teno1608/Do-An-Tot-Nghiep-2014/co cau leo thang.JPG

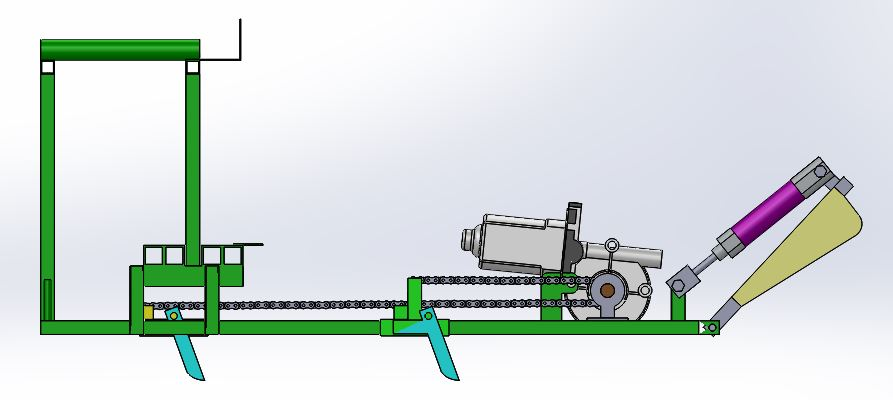
co cau leo thang.JPG
