teno1608/Do-An-Tot-Nghiep-2014/mater.JPG

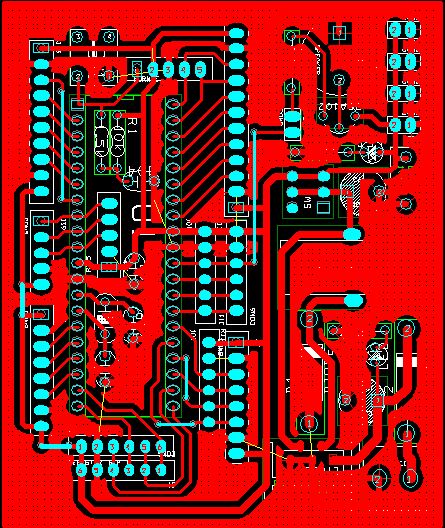
mater.JPG
