teno1608/Do-An-Tot-Nghiep-2014/anh tong the.JPG

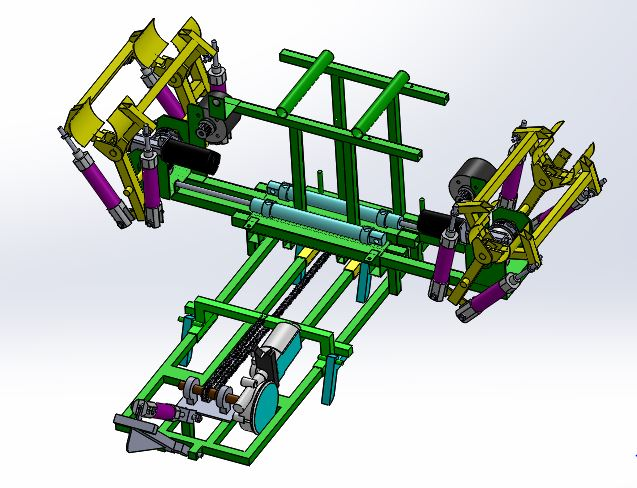
anh tong the.JPG
