teno1608/Do-An-Tot-Nghiep-2014/canh tay kep.JPG

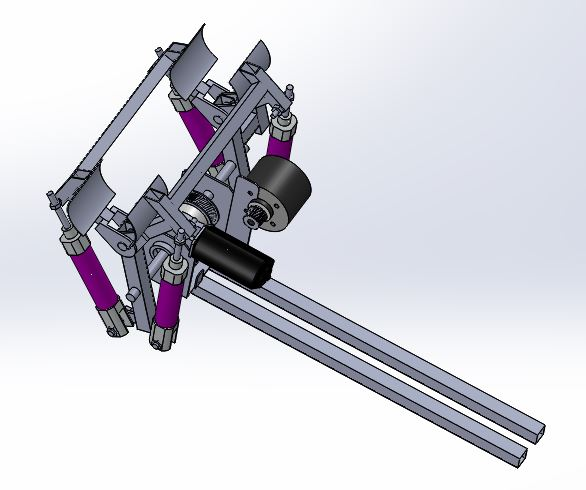
canh tay kep.JPG
