teno1608/Do-An-Tot-Nghiep-2014/Capture.JPG

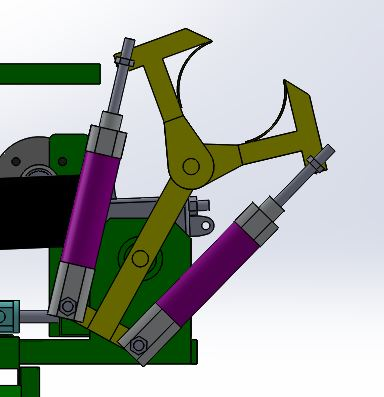
Capture.JPG
