teno1608/Do-An-Tot-Nghiep-2014/co cau giao tiep.JPG

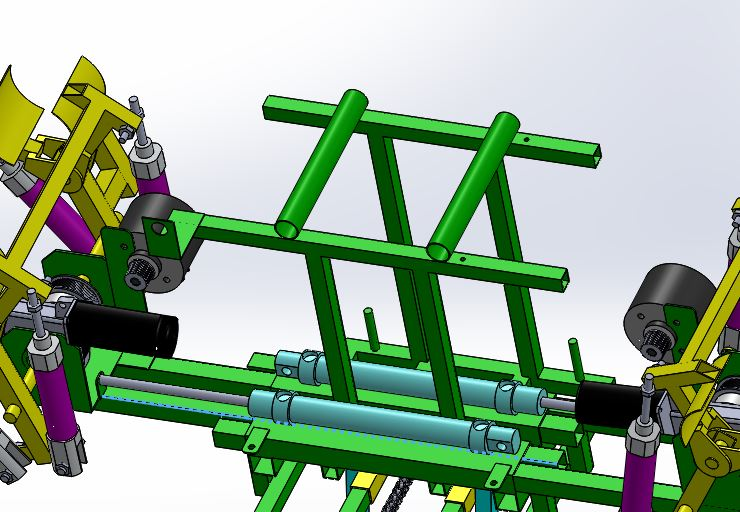
co cau giao tiep.JPG
