teno1608/Do-An-Tot-Nghiep-2014/co cau qua cot.JPG

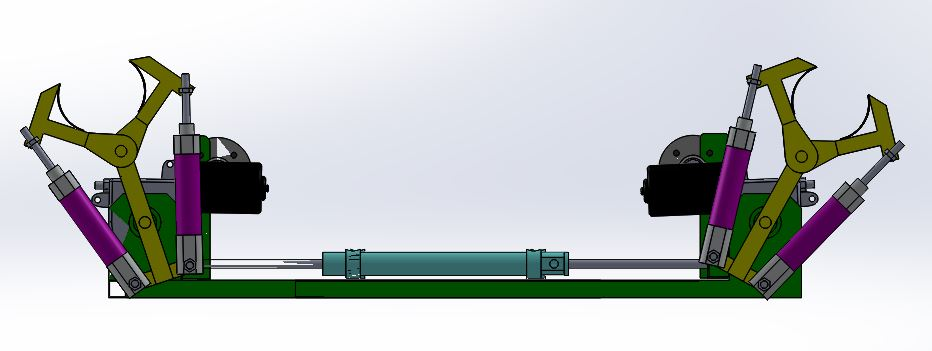
co cau qua cot.JPG
