teno1608/Do-An-Tot-Nghiep-2014/dluc.JPG

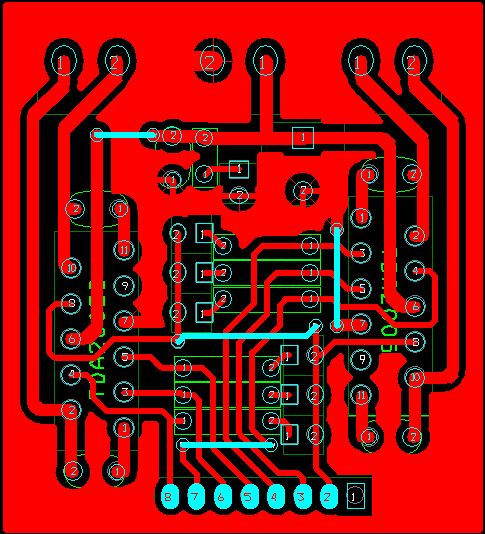
dluc.JPG
