teno1608/Do-An-Tot-Nghiep-2014/IMG_20140521_151754.jpg

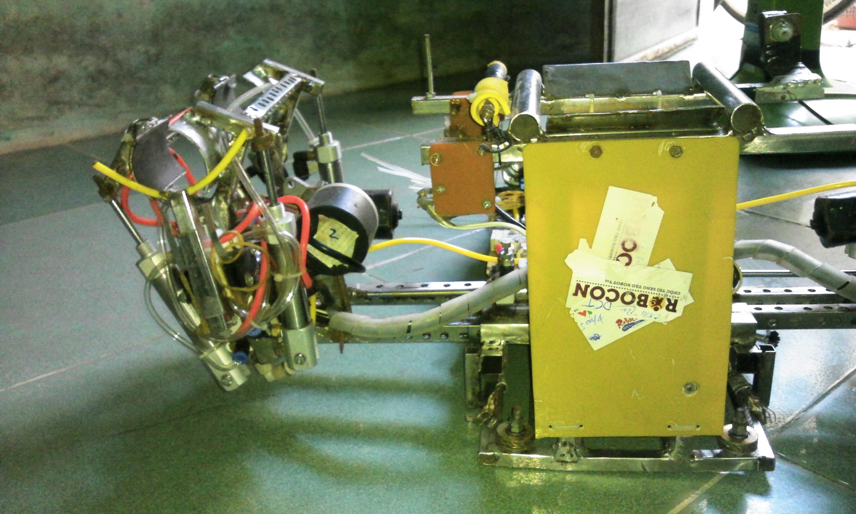
IMG_20140521_151754.jpg
