teno1608/Do-An-Tot-Nghiep-2014/kich van.JPG

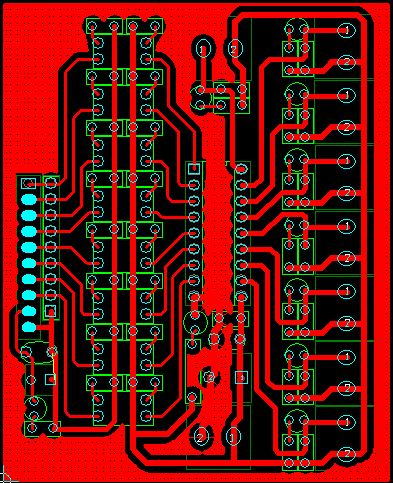
kich van.JPG
