teno1608/Do-An-Tot-Nghiep-2014/leo thang co cau.JPG

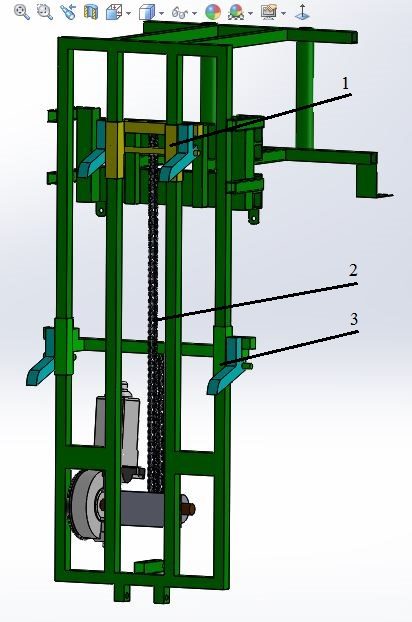
leo thang co cau.JPG
