teno1608/Do-An-Tot-Nghiep-2014/leo thang.JPG

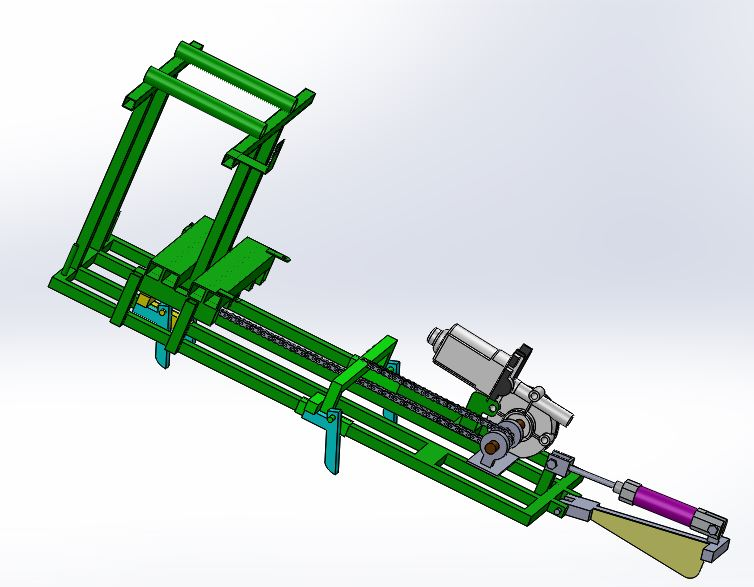
leo thang.JPG
