teno1608/Do-An-Tot-Nghiep-2014/luu do1.JPG

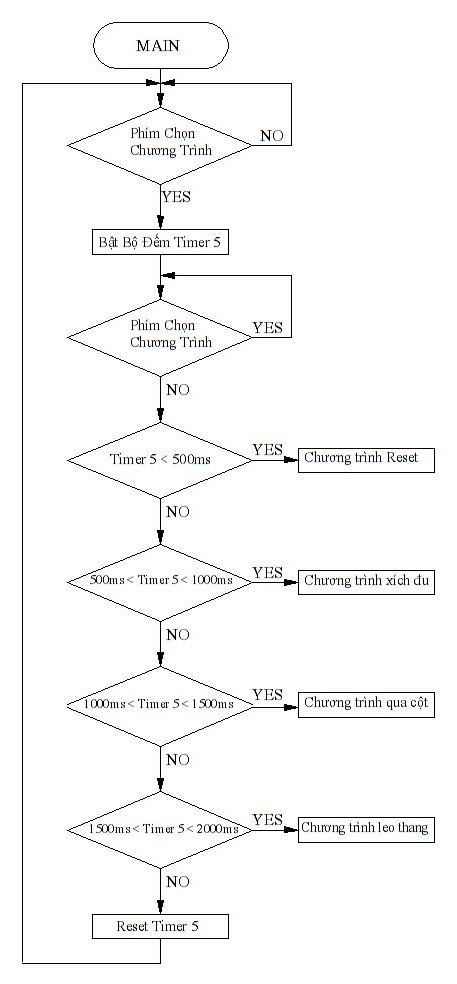
luu do1.JPG
