teno1608/Do-An-Tot-Nghiep-2014/luu do 2.JPG

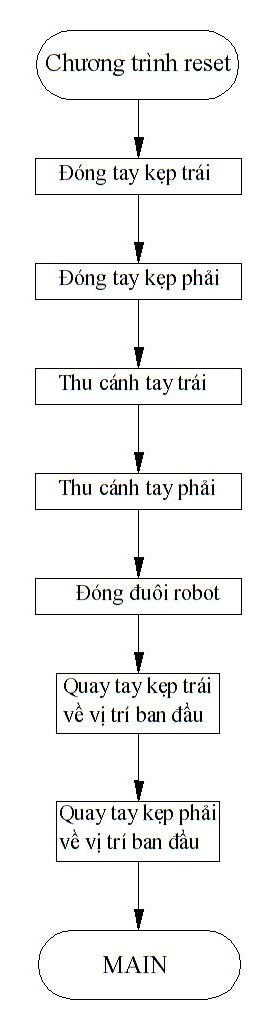
luu do 2.JPG
