teno1608/Do-An-Tot-Nghiep-2014/luu do 3.JPG

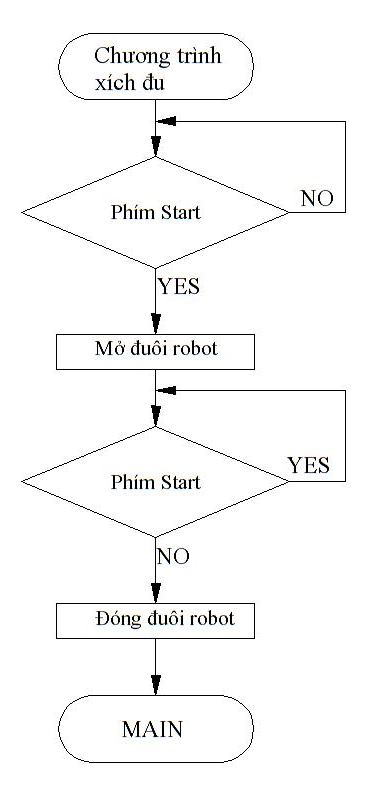
luu do 3.JPG
