teno1608/Do-An-Tot-Nghiep-2014/luu do 4.JPG

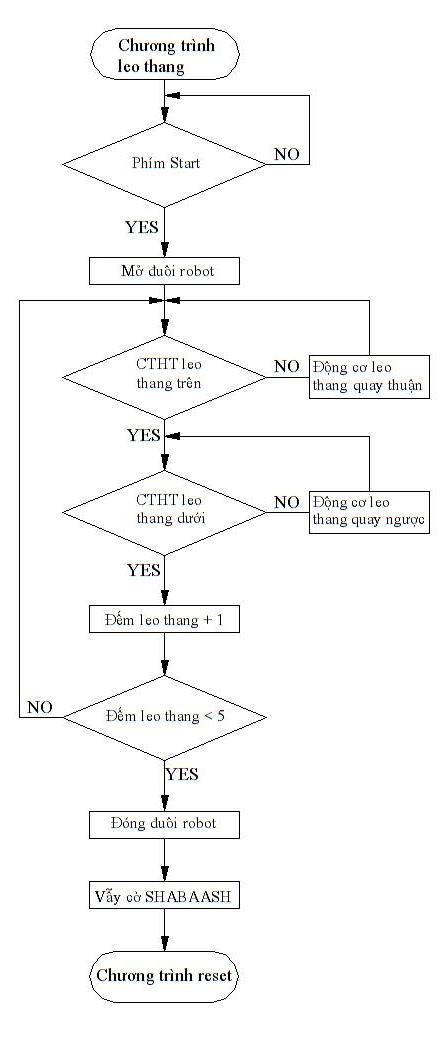
luu do 4.JPG
