teno1608/Do-An-Tot-Nghiep-2014/luu do 5.JPG

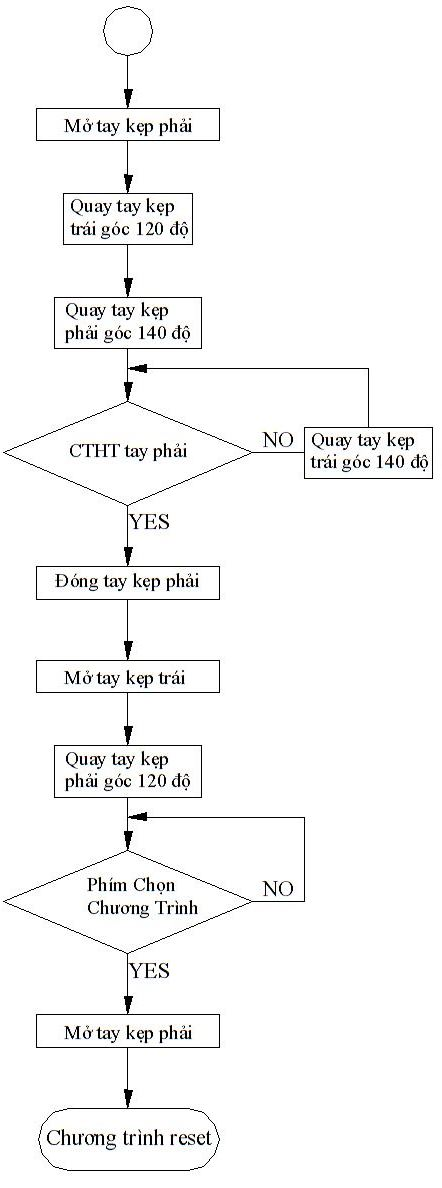
luu do 5.JPG
