teno1608/Do-An-Tot-Nghiep-2014/luu do 6.JPG

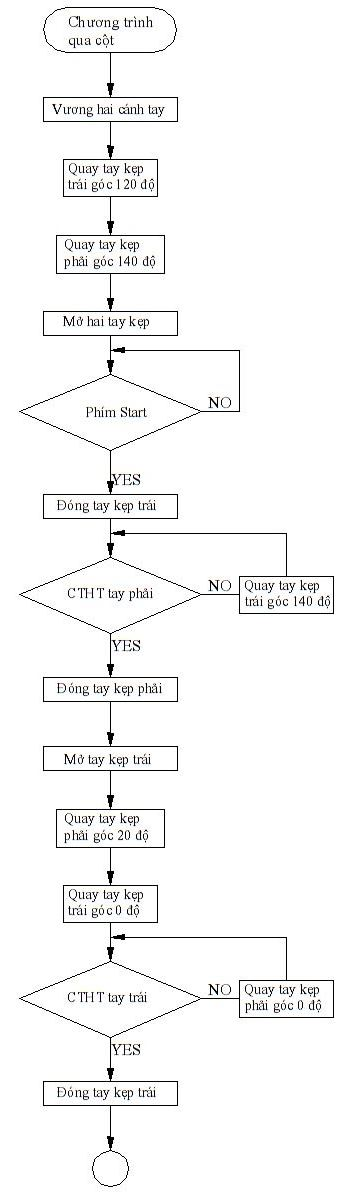
luu do 6.JPG
