teno1608/Do-An-Tot-Nghiep-2014/mach pid.JPG

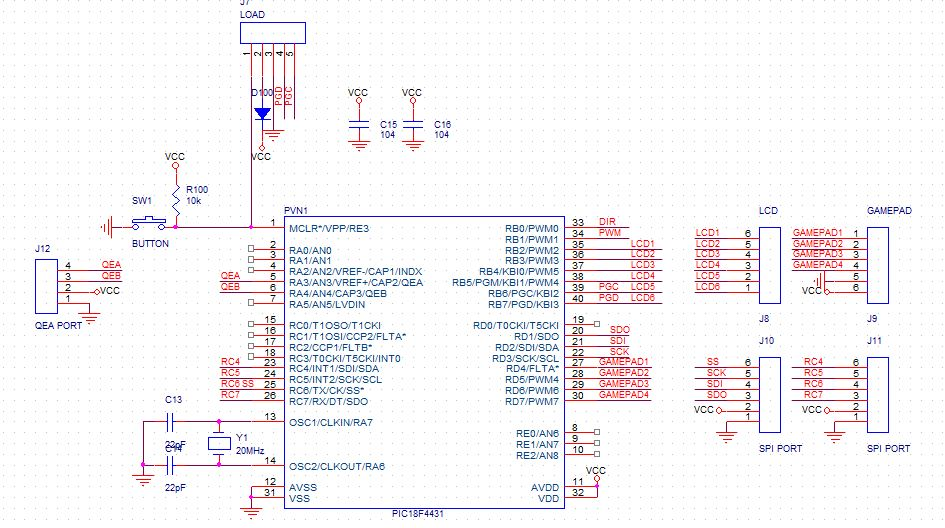
mach pid.JPG
