teno1608/Do-An-Tot-Nghiep-2014/mach trung tam.JPG

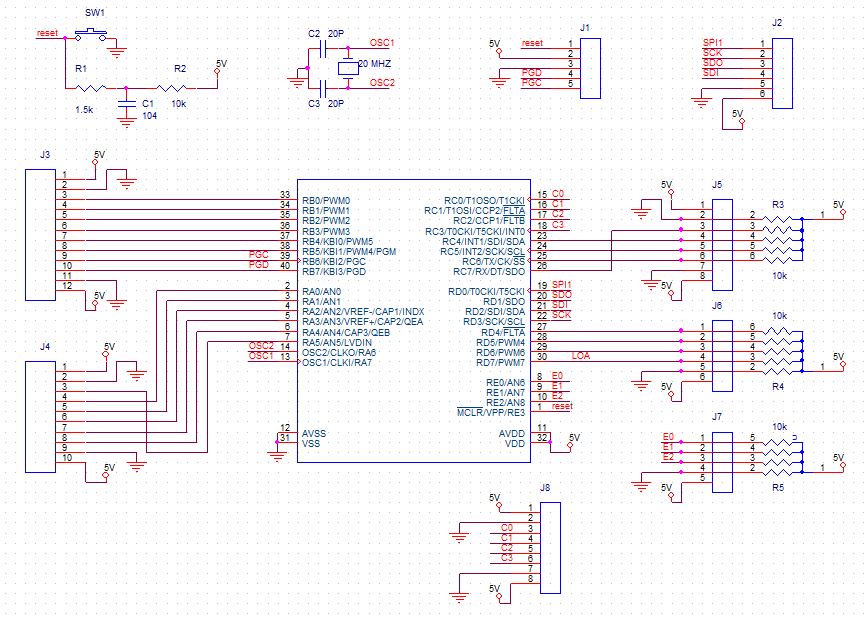
mach trung tam.JPG
