teno1608/Do-An-Tot-Nghiep-2014/pic18f.JPG

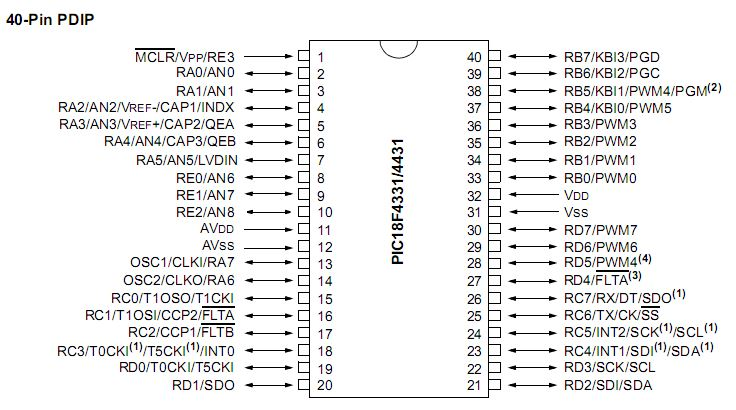
pic18f.JPG
