teno1608/Do-An-Tot-Nghiep-2014/quay dong co lep.JPG

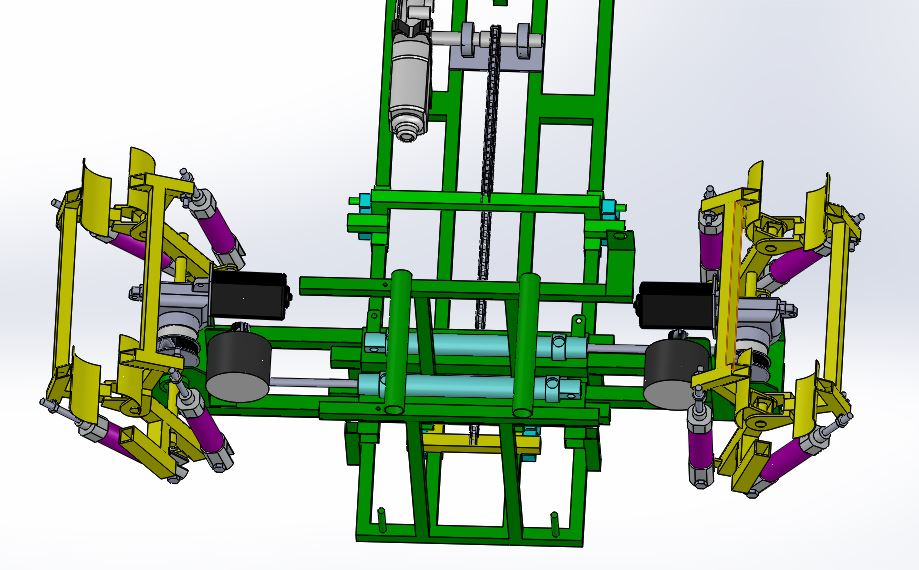
quay dong co lep.JPG
