teno1608/Do-An-Tot-Nghiep-2014/so do tinh kep.jpg

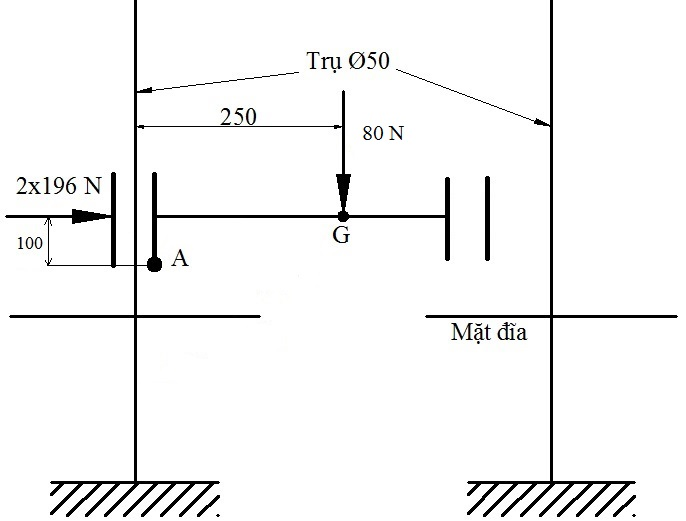
so do tinh kep.jpg
