teno1608/Do-An-Tot-Nghiep-2014/tinhlucleocauthang.JPG

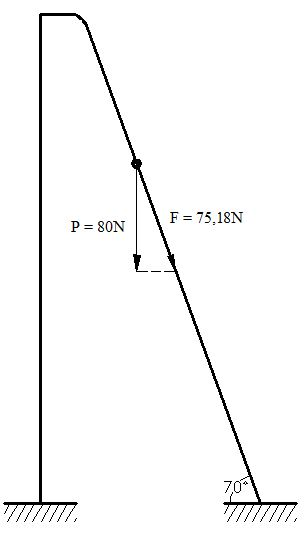
tinhlucleocauthang.JPG
