teno1608/Do-An-Tot-Nghiep-2014/auto/thư viện/onmi2/omni.SLDASM

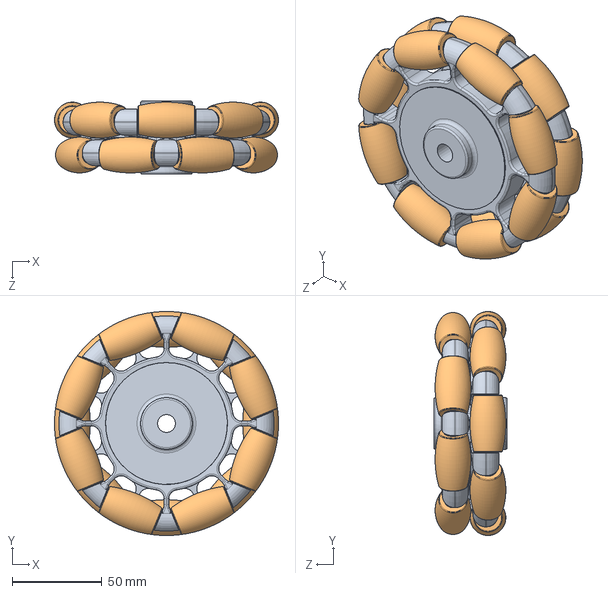
[picture p42: CAD file, 2022-07-13]
auto/thư viện/onmi2/omni.SLDASM
125.0 x 125.0 x 41.0 mm
don x 2
conlan x 16
