teno1608/Do-An-Tot-Nghiep-2014/auto/thư viện/onmi2/banh hoan chinh.SLDASM

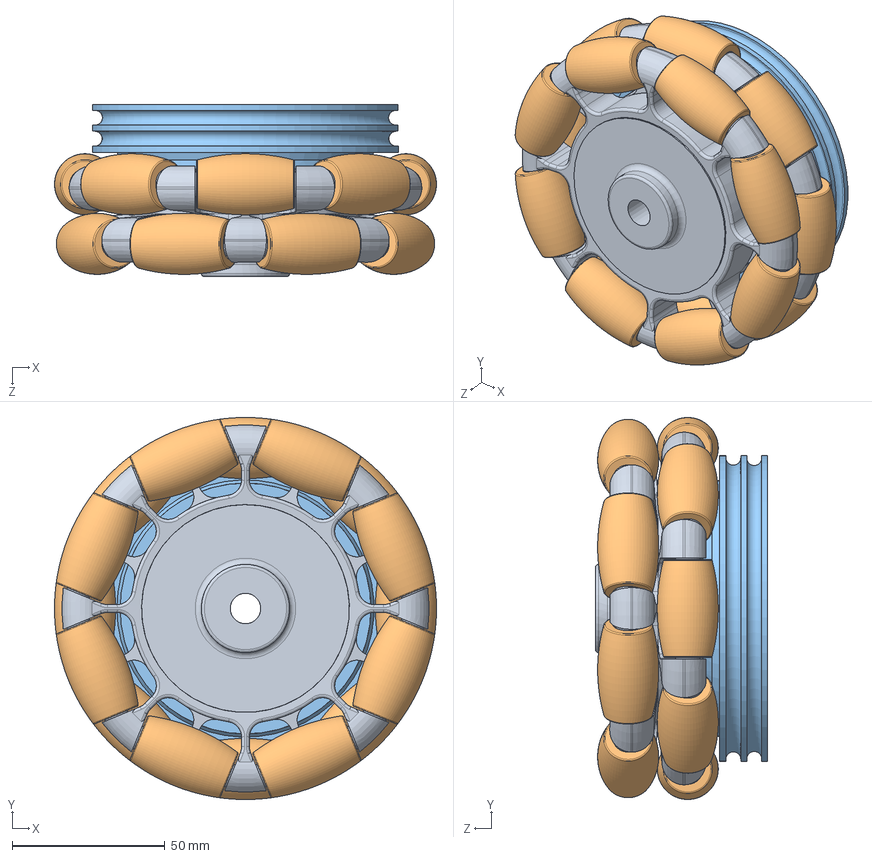
[picture p43: CAD file, 2022-07-13]
auto/thư viện/onmi2/banh hoan chinh.SLDASM
125.0 x 125.0 x 56.4 mm
don x 2
conlan x 16
buli_tua100
