teno1608/Do-An-Tot-Nghiep-2014/auto/encoder/laprap.SLDASM

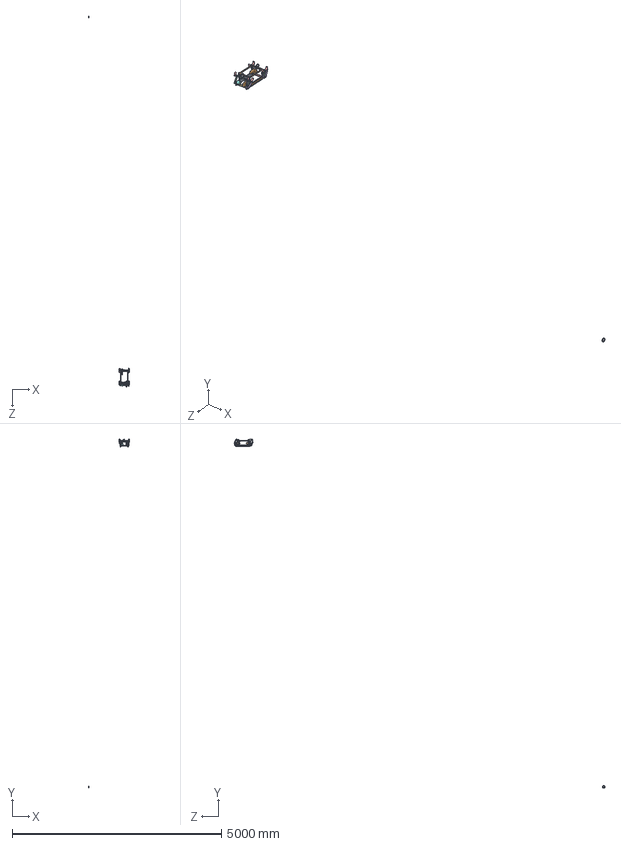
[picture p44: CAD file, 2022-07-13]
auto/encoder/laprap.SLDASM
980.0 x 8334.7 x 8854.6 mm
ray1 x 2
ray2 x 2
obi x 4
taykep x 2
hop20dai180
vuong20x20x20 x 2
hop20x10x160
ENCODER 100Xung
hop10x10x100 x 4
khung280x180
banle_1 x 8
banle_2 x 8
makep x 8
xilanh 30 x 4
daunoipitong x 4
trục 30 x 4
hotro x 3
dong co leb-phai x 2
