teno1608/Do-An-Tot-Nghiep-2014/auto/doan xich2.SLDASM

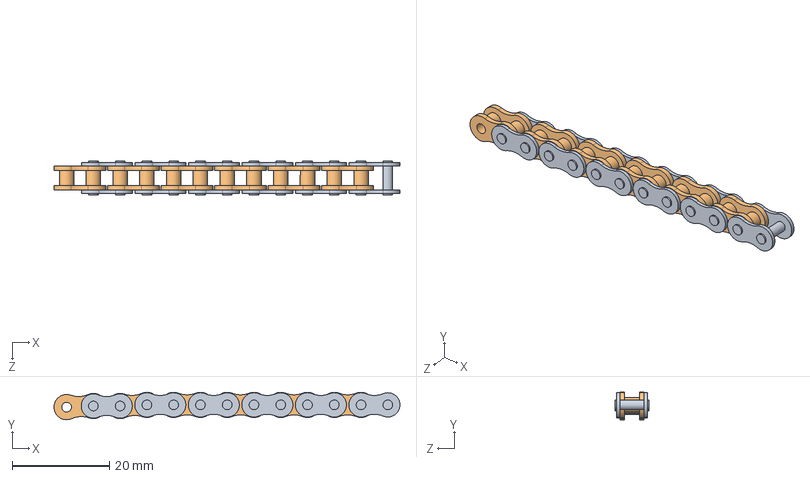
[picture p45: CAD file, 2022-07-13]
auto/doan xich2.SLDASM
71.1 x 5.66 x 7.00 mm
mac xich lon x 6
mac xich nho x 6
