teno1608/Do-An-Tot-Nghiep-2014/auto/thư viện/xilanh 200 mate.SLDPRT.SLDASM

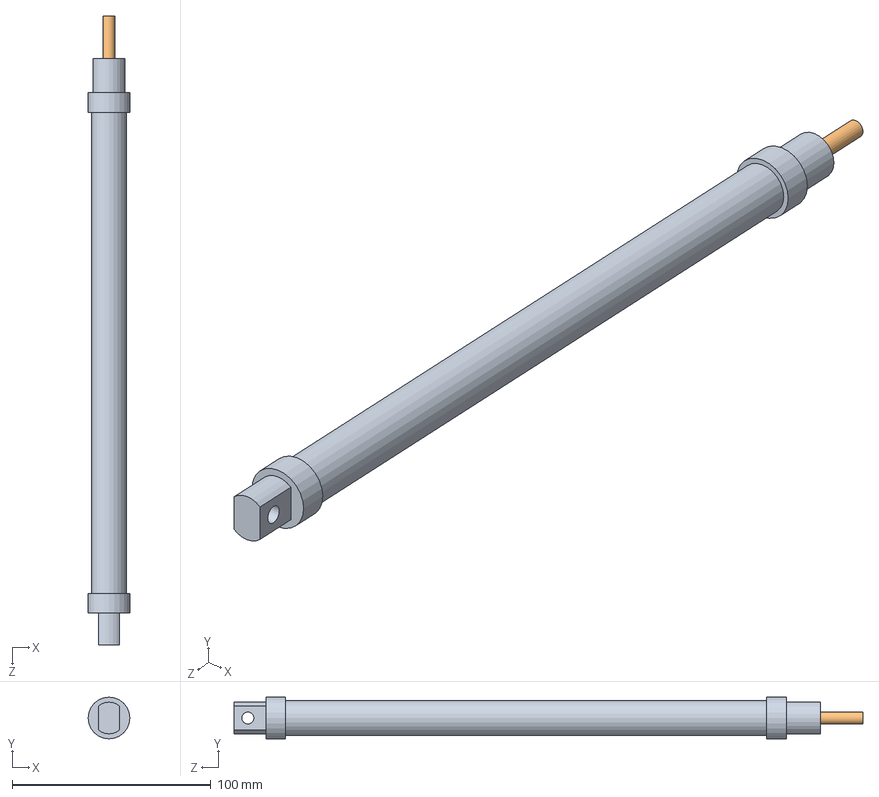
[picture p46: CAD file, 2022-07-13]
auto/thư viện/xilanh 200 mate.SLDPRT.SLDASM
21.0 x 21.0 x 316.5 mm
xilanh 200
trục xilanh 200
