teno1608/Do-An-Tot-Nghiep-2014/auto/lap rap canh tay phai.SLDASM

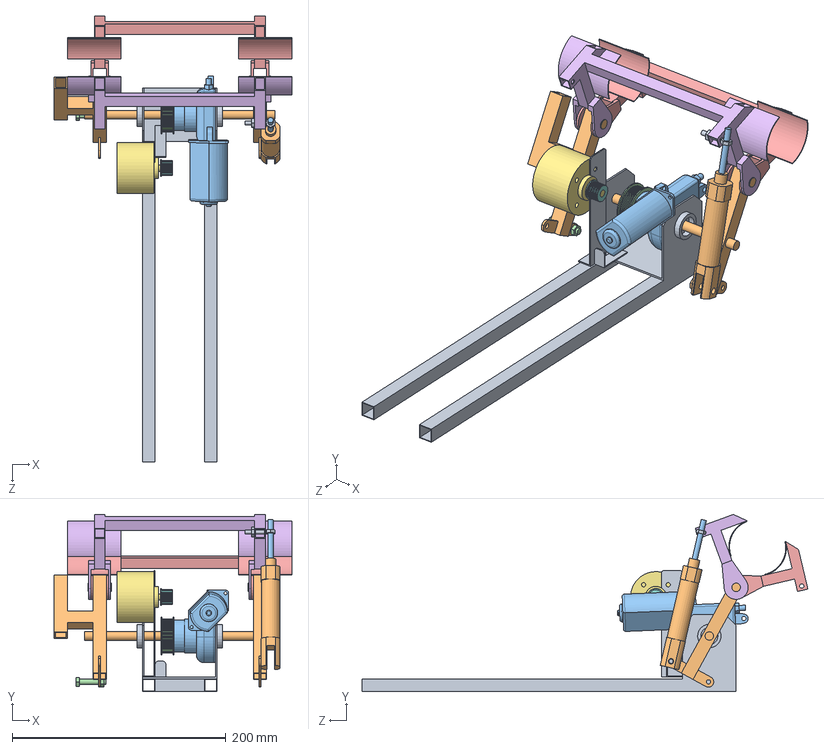
[picture p47: CAD file, 2022-07-13]
auto/lap rap canh tay phai.SLDASM
222.8 x 165.8 x 417.3 mm
than tay kep
ma kep phai
ma kep trai
