teno1608/Do-An-Tot-Nghiep-2014/auto/lap rap auto.SLDASM

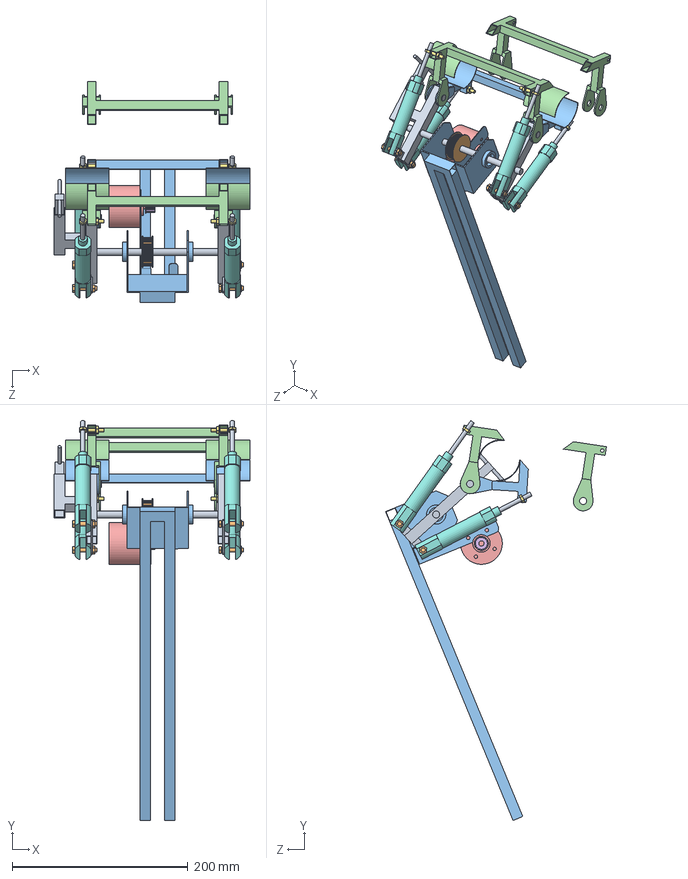
[picture p49: CAD file, 2022-07-13]
auto/lap rap auto.SLDASM
222.8 x 454.9 x 251.3 mm
than tay kep
banh rrang encoder
ma kep phai
ma kep trai
ENCODER 100Xung
banh rang encoder nho
oc pitong x 4
xilanh 30 x 4
trục xilanh 50 x 4
oc pitong duoi x 4
raytrai
