teno1608/Do-An-Tot-Nghiep-2014/auto/thư viện/xilanh 50 mate.SLDASM

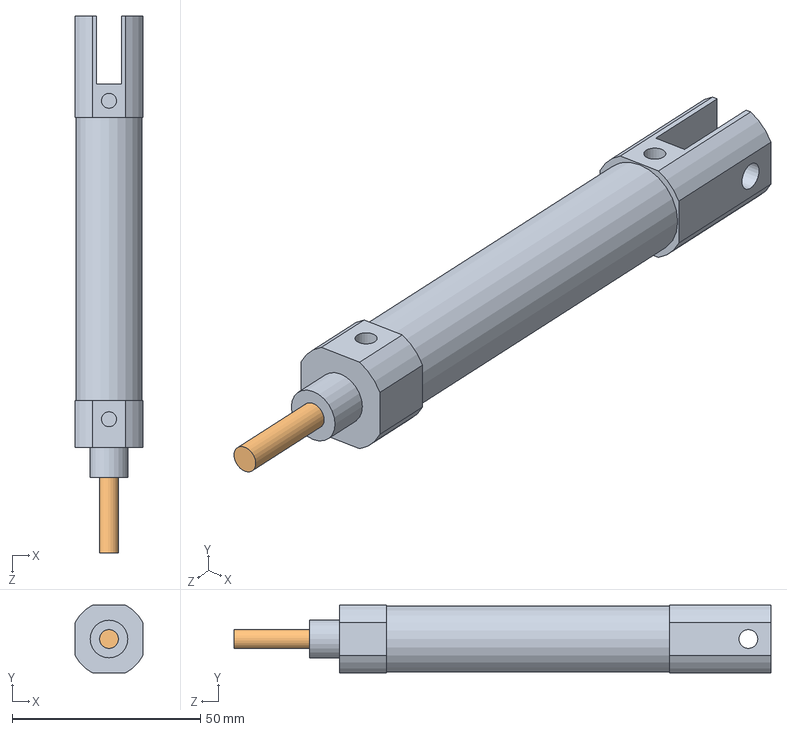
[picture p50: CAD file, 2022-07-13]
auto/thư viện/xilanh 50 mate.SLDASM
18.0 x 18.0 x 142.5 mm
xilanh 50
trục xilanh 50
