teno1608/Do-An-Tot-Nghiep-2014/auto/lap rap canh tay trai.SLDASM

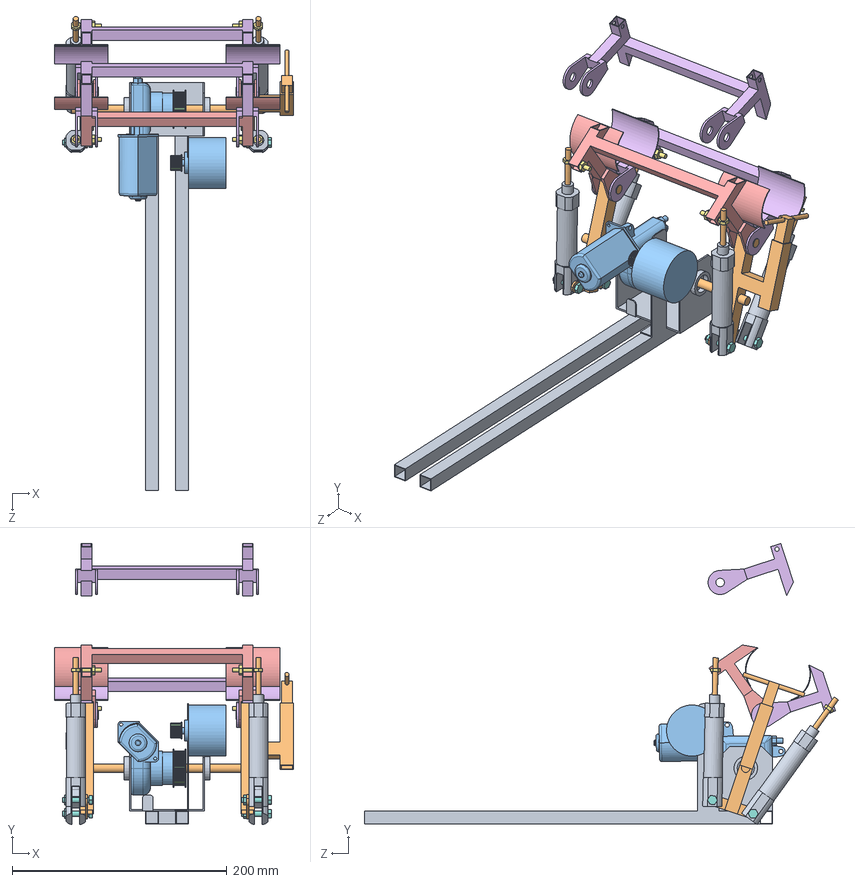
[picture p51: CAD file, 2022-07-13]
auto/lap rap canh tay trai.SLDASM
222.8 x 261.7 x 441.3 mm
raytrai
than tay kep
dong co led trai tay
banh rrang encoder
ma kep phai
ma kep trai
oc pitong x 4
oc pitong duoi x 4
xilanh 30 x 4
trục xilanh 50 x 4
ENCODER 100Xung
banh rang encoder nho
