teno1608/Do-An-Tot-Nghiep-2014/auto/nhong xich.SLDASM

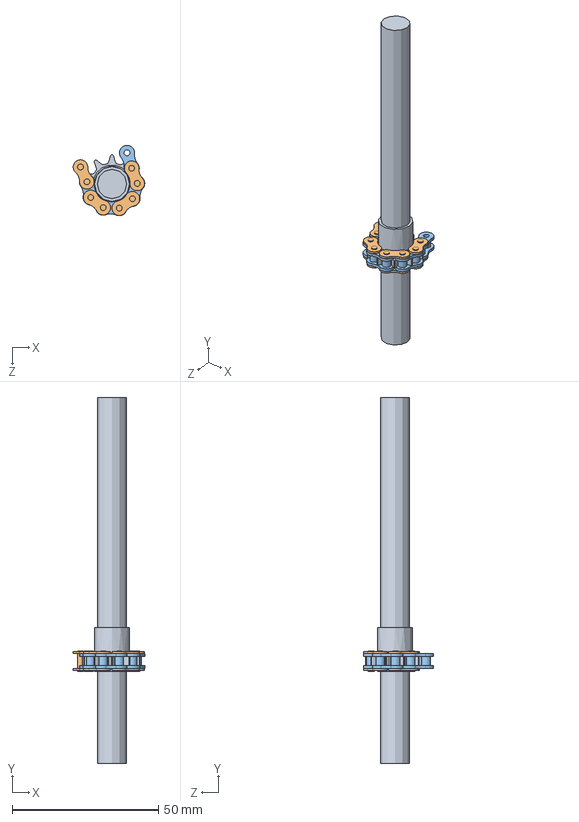
[picture p52: CAD file, 2022-07-13]
auto/nhong xich.SLDASM
24.5 x 125.0 x 24.1 mm
nhoong
mac xich lon x 4
mac xich nho x 4
