teno1608/Do-An-Tot-Nghiep-2014/auto/thư viện/xilanh 75 mate.SLDASM

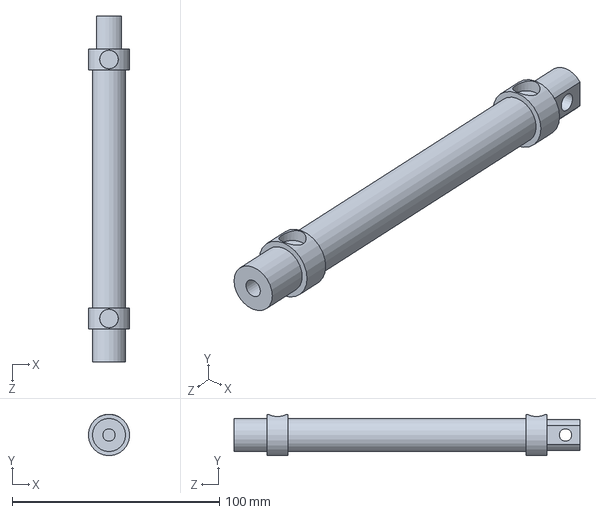
[picture p53: CAD file, 2022-07-13]
auto/thư viện/xilanh 75 mate.SLDASM
20.0 x 20.0 x 167.0 mm
