teno1608/Do-An-Tot-Nghiep-2014/auto/lap rap hoan chinh auto robot.SLDASM

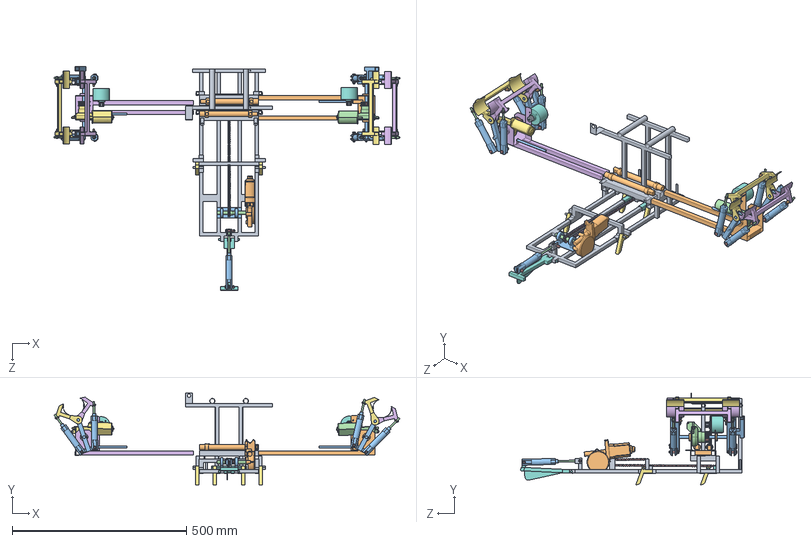
[picture p54: CAD file, 2022-07-13]
auto/lap rap hoan chinh auto robot.SLDASM
993.7 x 263.5 x 642.3 mm
de auto
rayphai
than tay kep x 2
dong co led phai tay
banh rrang encoder x 2
ma kep phai x 2
ma kep trai x 2
ENCODER 100Xung x 2
banh rang encoder nho x 2
oc pitong x 8
xilanh 30 x 9
trục xilanh 50 x 9
oc pitong duoi x 10
raytrai
dong co led trai tay
ray_truot_giua
ray_truot_ben
dong co leb
o do bi leo thang
nhoong
mac xich lon x 46
mac xich nho x 46
lay x 4
duoi
chu u
xilanh HT75 pi 16 x 2
trục xilanh 75 x 2
