teno1608/Do-An-Tot-Nghiep-2014/auto/thư viện/xilanh 100 mate.SLDASM

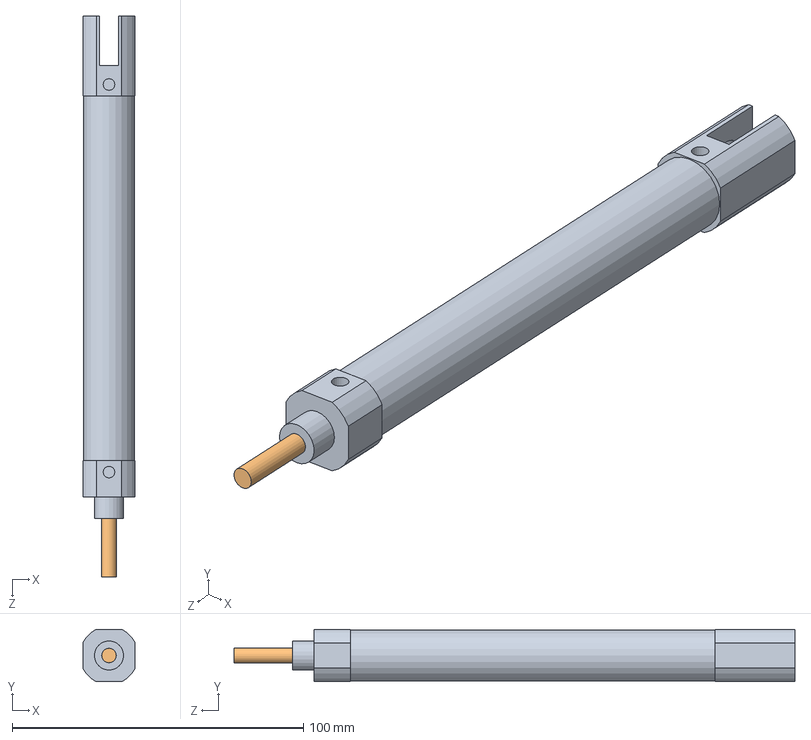
[picture p55: CAD file, 2022-07-13]
auto/thư viện/xilanh 100 mate.SLDASM
18.0 x 18.0 x 192.5 mm
xilanh 100
trục xilanh 100
