teno1608/Do-An-Tot-Nghiep-2014/auto/trượt lên thang trong.SLDASM

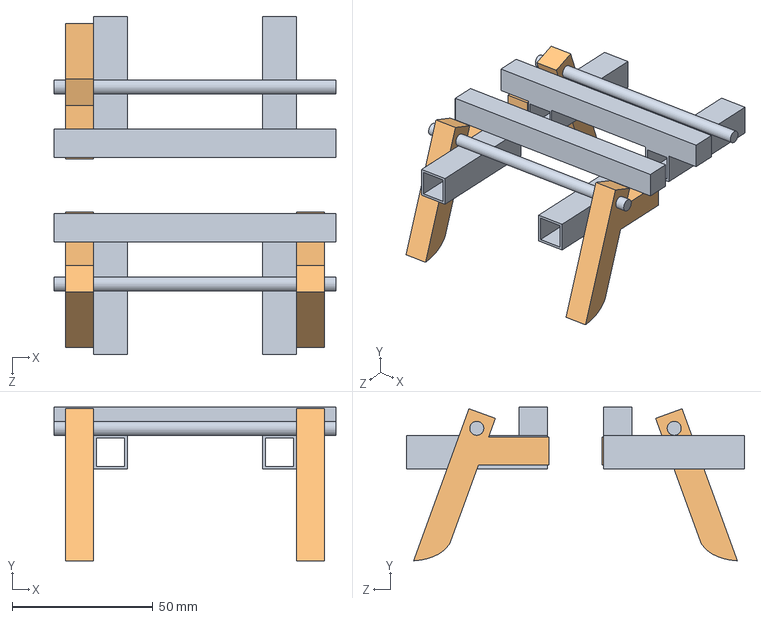
[picture p56: CAD file, 2022-07-13]
auto/trượt lên thang trong.SLDASM
100.0 x 54.5 x 120.0 mm
lay x 2
ray_truot_giua
