teno1608/Do-An-Tot-Nghiep-2014/auto/cơ cấu trượt lên thang ngoài.SLDASM

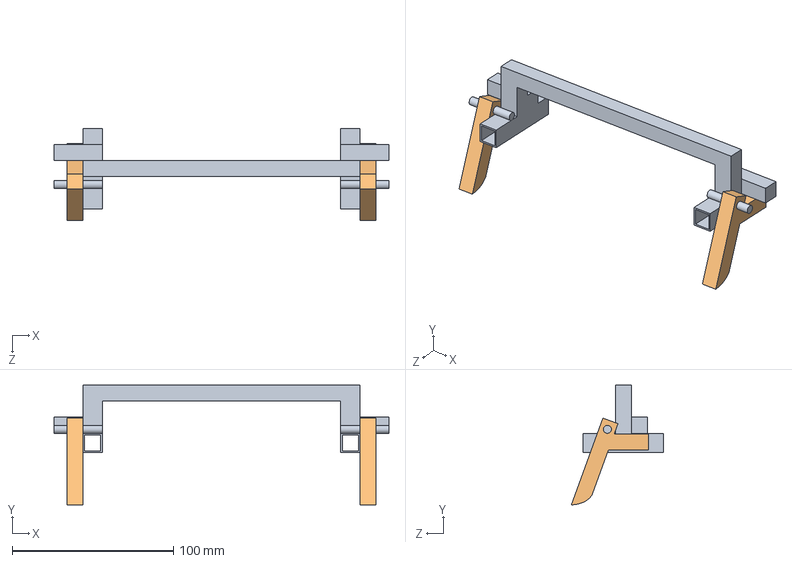
[picture p57: CAD file, 2022-07-13]
auto/cơ cấu trượt lên thang ngoài.SLDASM
208.0 x 74.5 x 57.4 mm
ray_truot_ben
lay x 2
