teno1608/Do-An-Tot-Nghiep-2014/auto/thư viện/xilanh 30 mate.SLDASM

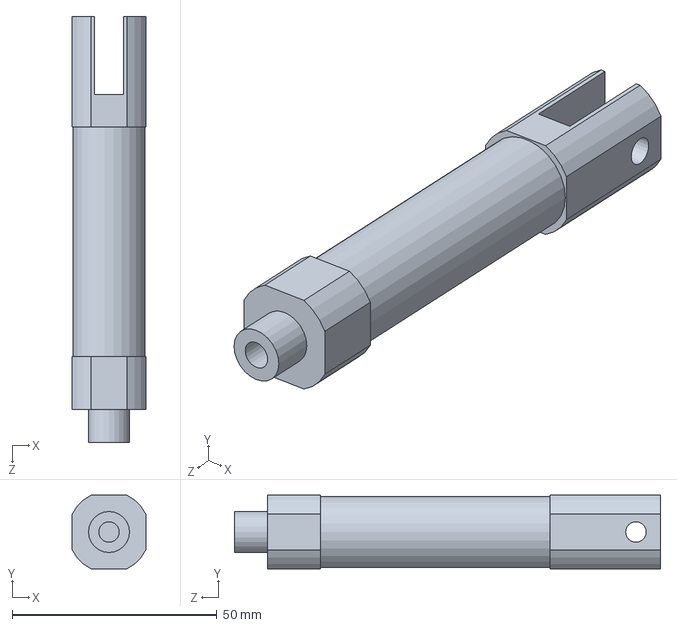
[picture p58: CAD file, 2022-07-13]
auto/thư viện/xilanh 30 mate.SLDASM
18.0 x 18.0 x 104.0 mm
