teno1608/Do-An-Tot-Nghiep-2014/auto/dong co led phai tay.SLDPRT

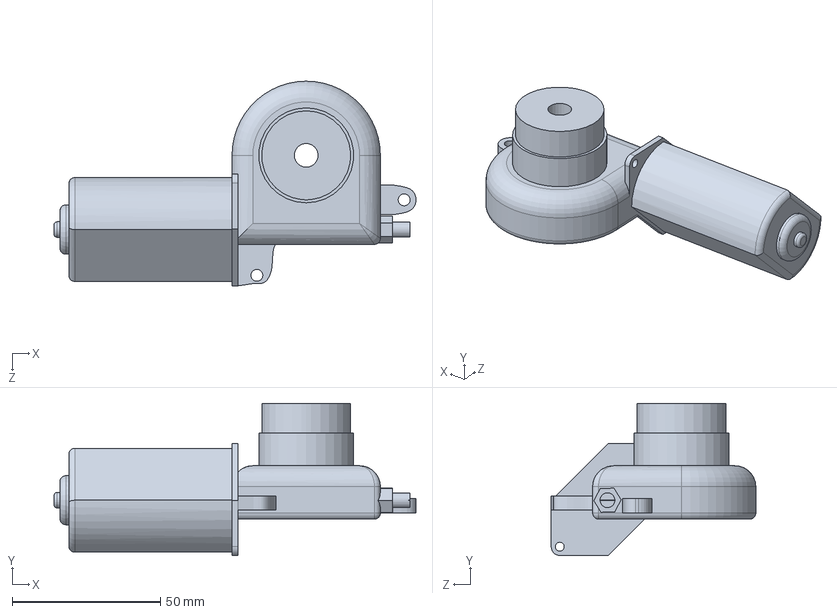
[picture p59: CAD file, 2022-07-13]
auto/dong co led phai tay.SLDPRT
122.0 x 51.3 x 69.0 mm
