teno1608/Do-An-Tot-Nghiep-2014/auto/thư viện/onmi2/conlan.SLDPRT

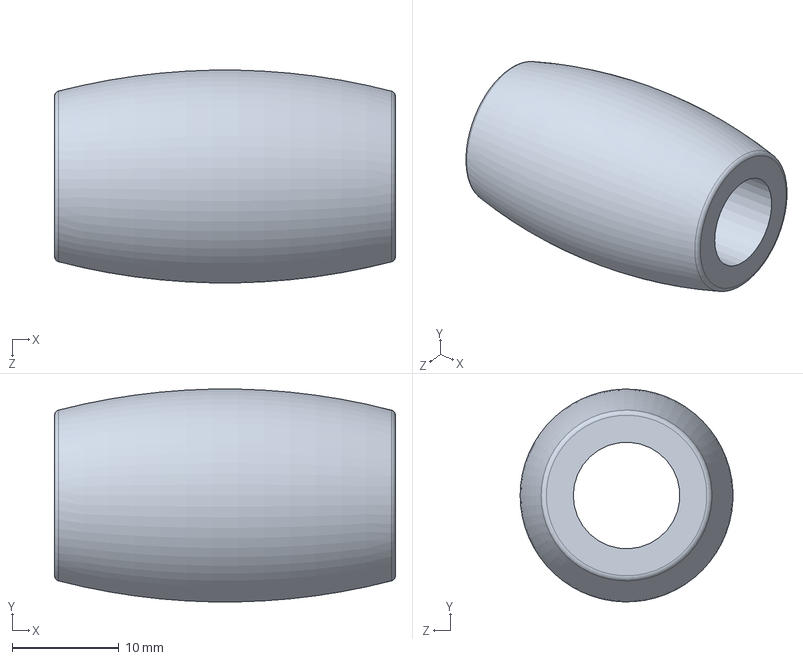
[picture p60: CAD file, 2022-07-13]
auto/thư viện/onmi2/conlan.SLDPRT
32.0 x 20.0 x 20.0 mm
