teno1608/Do-An-Tot-Nghiep-2014/auto/thư viện/trục xilanh 200.SLDPRT

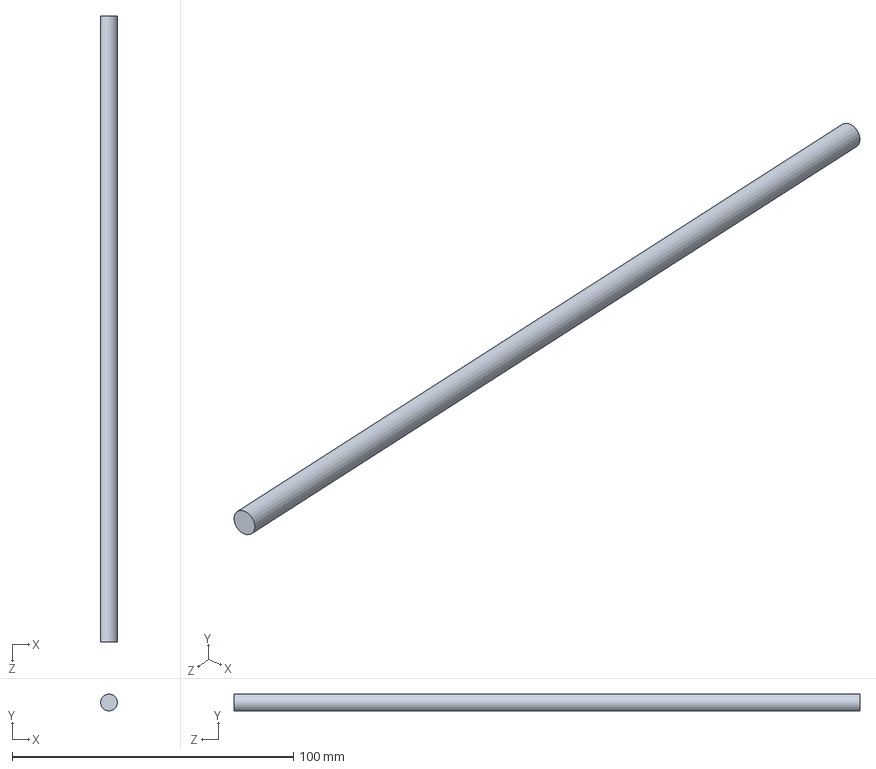
[picture p61: CAD file, 2022-07-13]
auto/thư viện/trục xilanh 200.SLDPRT
6.00 x 6.00 x 222.5 mm
