teno1608/Do-An-Tot-Nghiep-2014/auto/than tay kep.SLDPRT

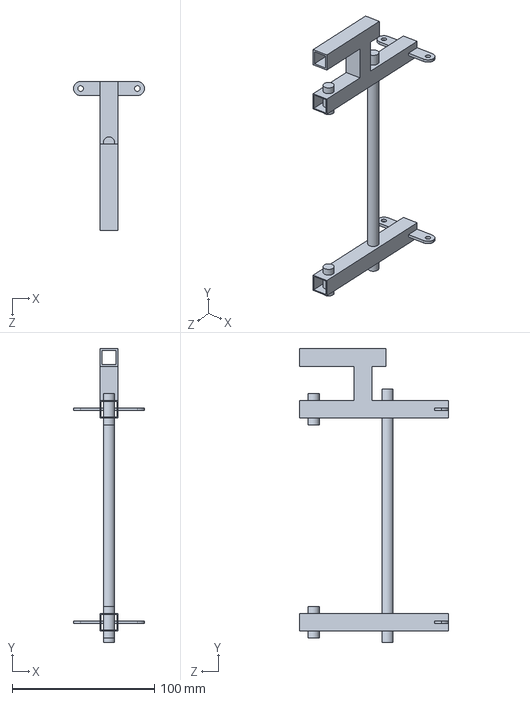
[picture p62: CAD file, 2022-07-13]
auto/than tay kep.SLDPRT
50.0 x 207.0 x 105.0 mm
