teno1608/Do-An-Tot-Nghiep-2014/auto/thư viện/trục 30.SLDPRT

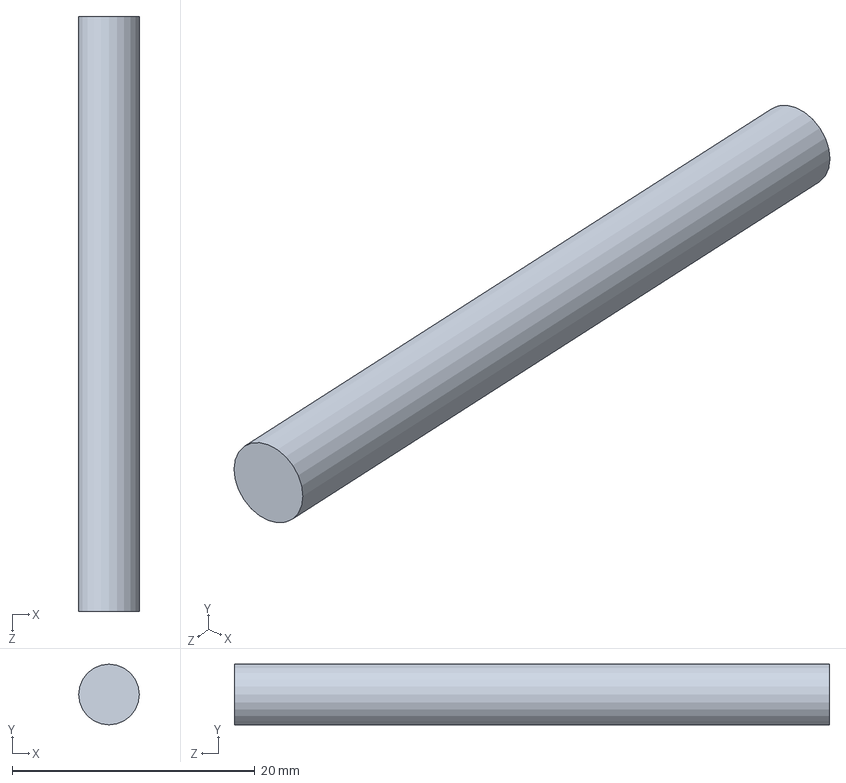
[picture p63: CAD file, 2022-07-13]
auto/thư viện/trục 30.SLDPRT
5.00 x 5.00 x 49.0 mm
