teno1608/Do-An-Tot-Nghiep-2014/auto/thư viện/buli_tua100.SLDPRT

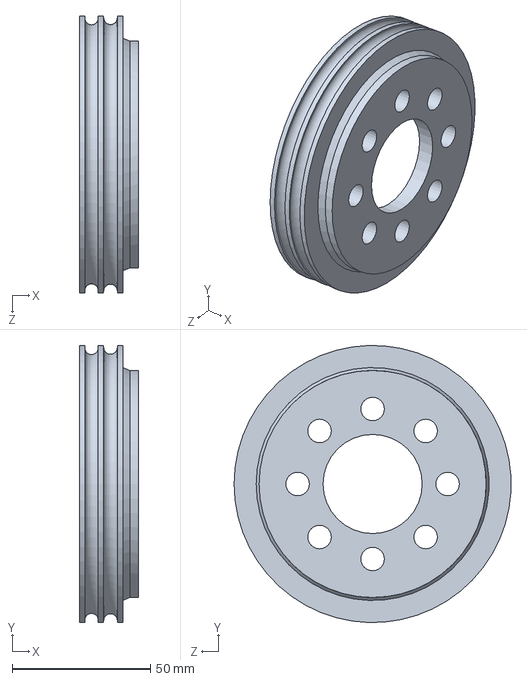
[picture p64: CAD file, 2022-07-13]
auto/thư viện/buli_tua100.SLDPRT
21.4 x 100.1 x 100.0 mm
