teno1608/Do-An-Tot-Nghiep-2014/auto/encoder/vuong20x20x20.SLDPRT

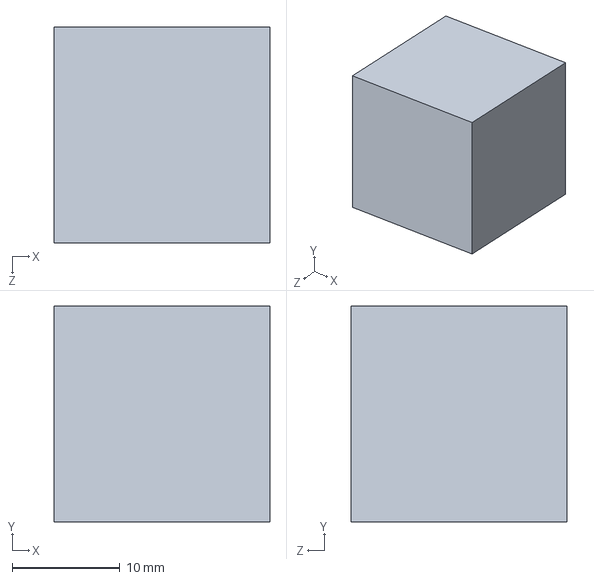
[picture p65: CAD file, 2022-07-13]
auto/encoder/vuong20x20x20.SLDPRT
20.0 x 20.0 x 20.0 mm
