teno1608/Do-An-Tot-Nghiep-2014/auto/thư viện/onmi2/don.SLDPRT

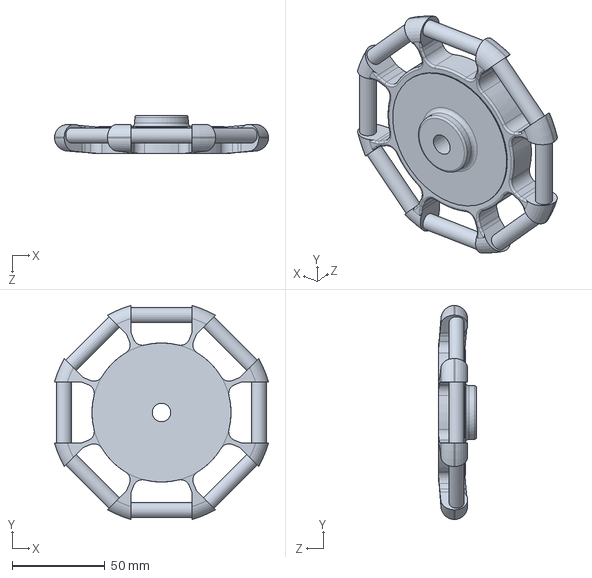
[picture p66: CAD file, 2022-07-13]
auto/thư viện/onmi2/don.SLDPRT
115.4 x 115.4 x 20.5 mm
