teno1608/Do-An-Tot-Nghiep-2014/auto/mac xich lon.SLDPRT

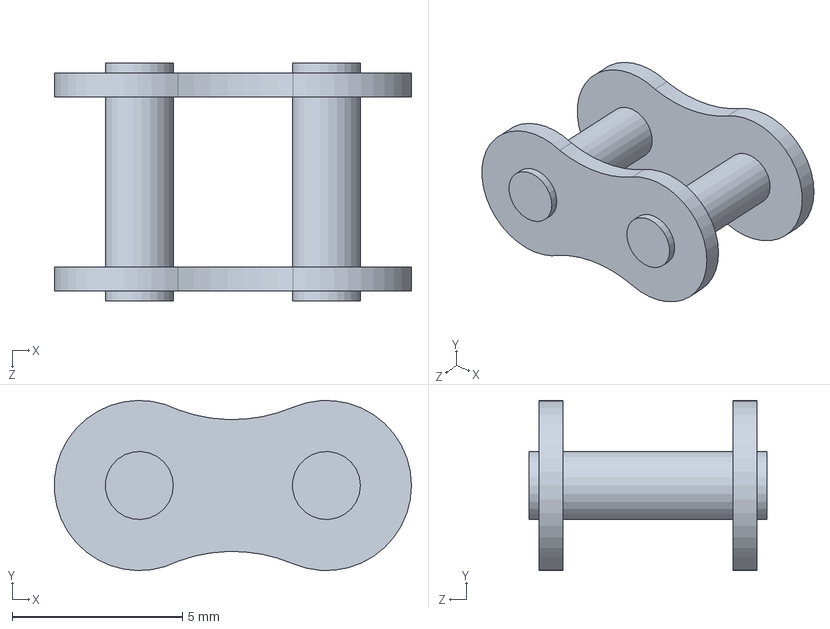
[picture p67: CAD file, 2022-07-13]
auto/mac xich lon.SLDPRT
10.5 x 5.00 x 7.00 mm
