teno1608/Do-An-Tot-Nghiep-2014/auto/thư viện/xilanh 200.SLDPRT

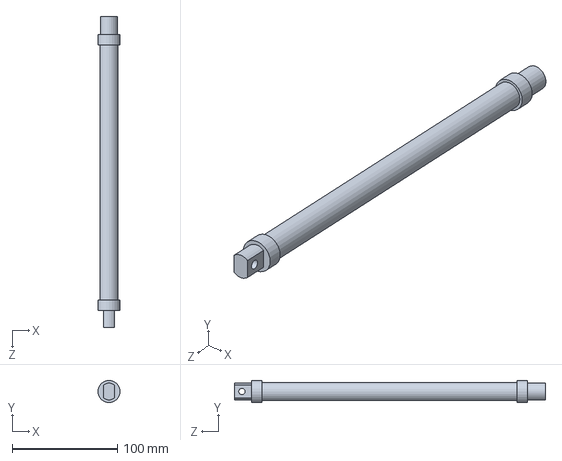
[picture p68: CAD file, 2022-07-13]
auto/thư viện/xilanh 200.SLDPRT
21.0 x 21.0 x 295.0 mm
