teno1608/Do-An-Tot-Nghiep-2014/auto/encoder/ENCODER 100Xung.SLDPRT

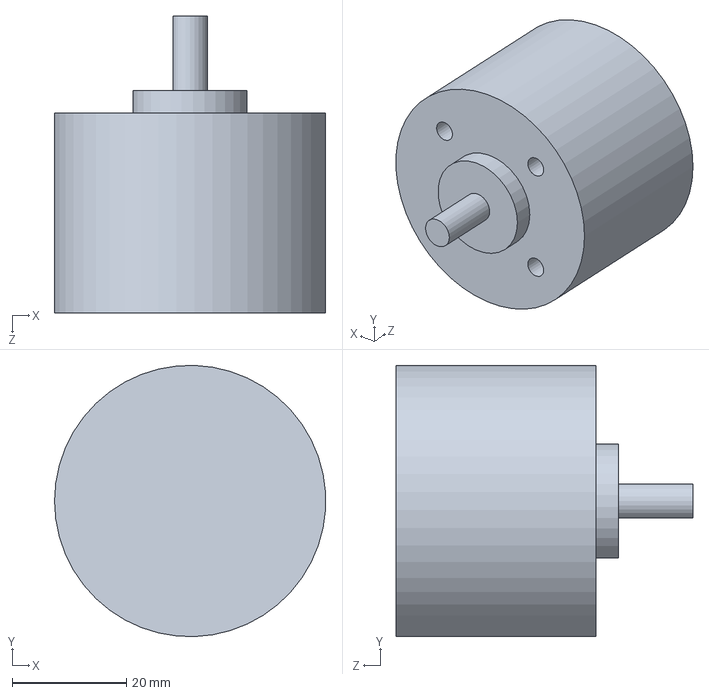
[picture p69: CAD file, 2022-07-13]
auto/encoder/ENCODER 100Xung.SLDPRT
47.5 x 47.5 x 52.0 mm
