teno1608/Do-An-Tot-Nghiep-2014/auto/ray_truot_giua.SLDPRT

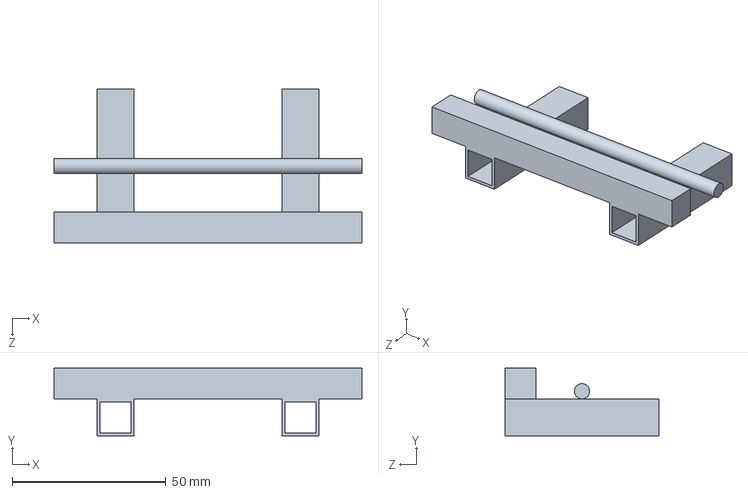
[picture p70: CAD file, 2022-07-13]
auto/ray_truot_giua.SLDPRT
100.0 x 22.0 x 50.0 mm
