teno1608/Do-An-Tot-Nghiep-2014/auto/thư viện/bachbatpittomhlon.SLDPRT

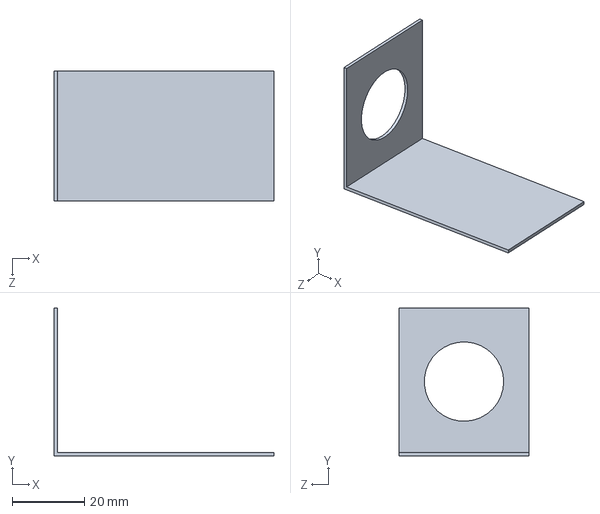
[picture p71: CAD file, 2022-07-13]
auto/thư viện/bachbatpittomhlon.SLDPRT
61.0 x 41.0 x 36.0 mm
