teno1608/Do-An-Tot-Nghiep-2014/auto/banh rang encoder nho.SLDPRT

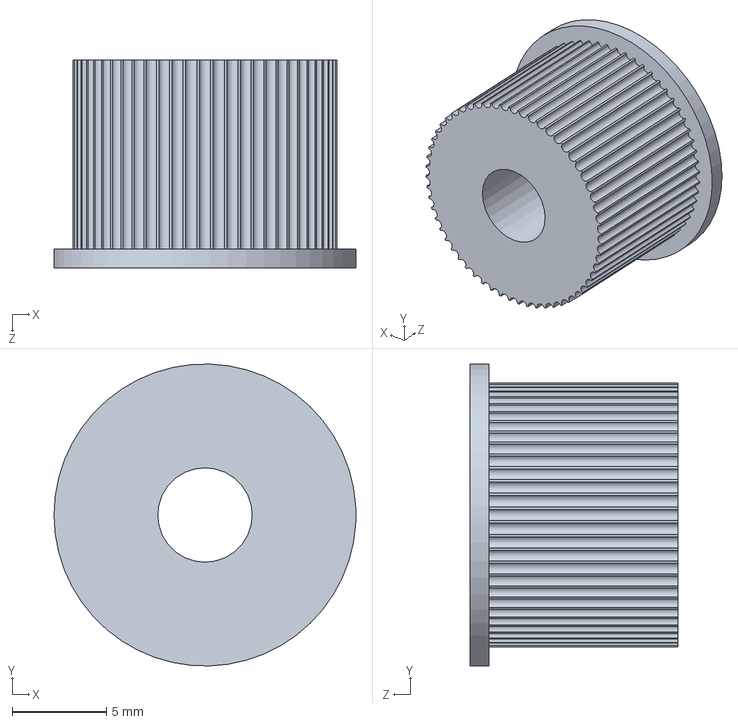
[picture p72: CAD file, 2022-07-13]
auto/banh rang encoder nho.SLDPRT
16.0 x 16.0 x 11.0 mm
