teno1608/Do-An-Tot-Nghiep-2014/auto/encoder/binhkhinen.SLDPRT

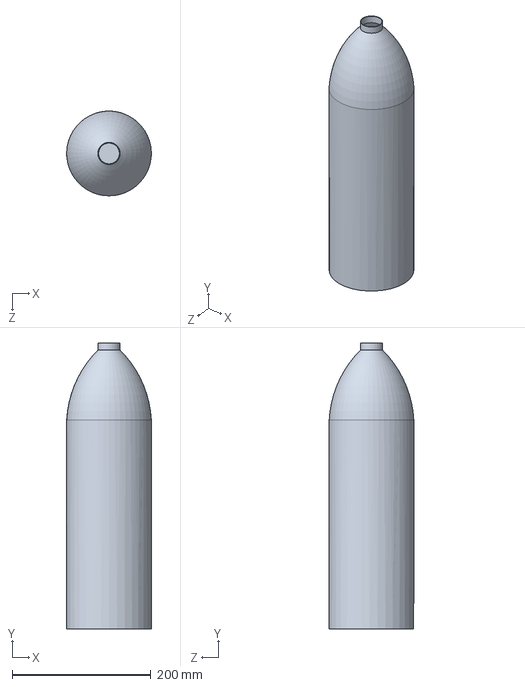
[picture p73: CAD file, 2022-07-13]
auto/encoder/binhkhinen.SLDPRT
121.9 x 411.6 x 121.9 mm
