teno1608/Do-An-Tot-Nghiep-2014/auto/thư viện/trucpittong400.SLDPRT

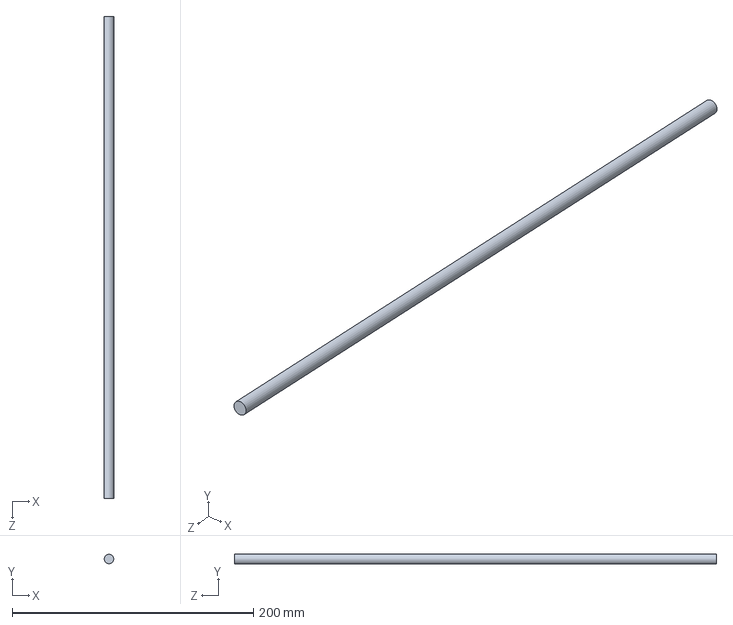
[picture p74: CAD file, 2022-07-13]
auto/thư viện/trucpittong400.SLDPRT
8.00 x 8.00 x 400.0 mm
