teno1608/Do-An-Tot-Nghiep-2014/auto/duoi.SLDPRT

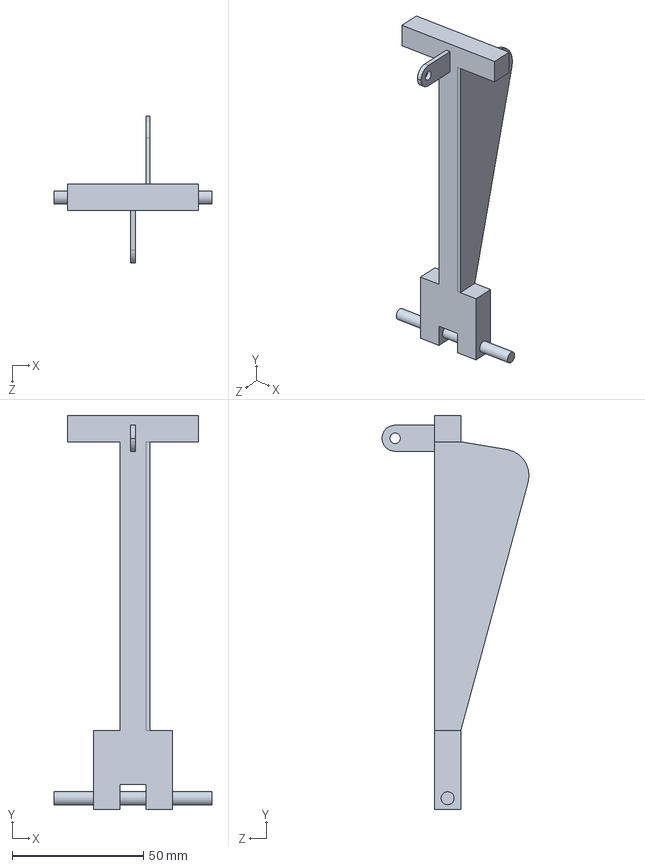
[picture p75: CAD file, 2022-07-13]
auto/duoi.SLDPRT
60.0 x 150.0 x 56.0 mm
