teno1608/Do-An-Tot-Nghiep-2014/auto/thư viện/xilanh HT50 pi 16.SLDPRT

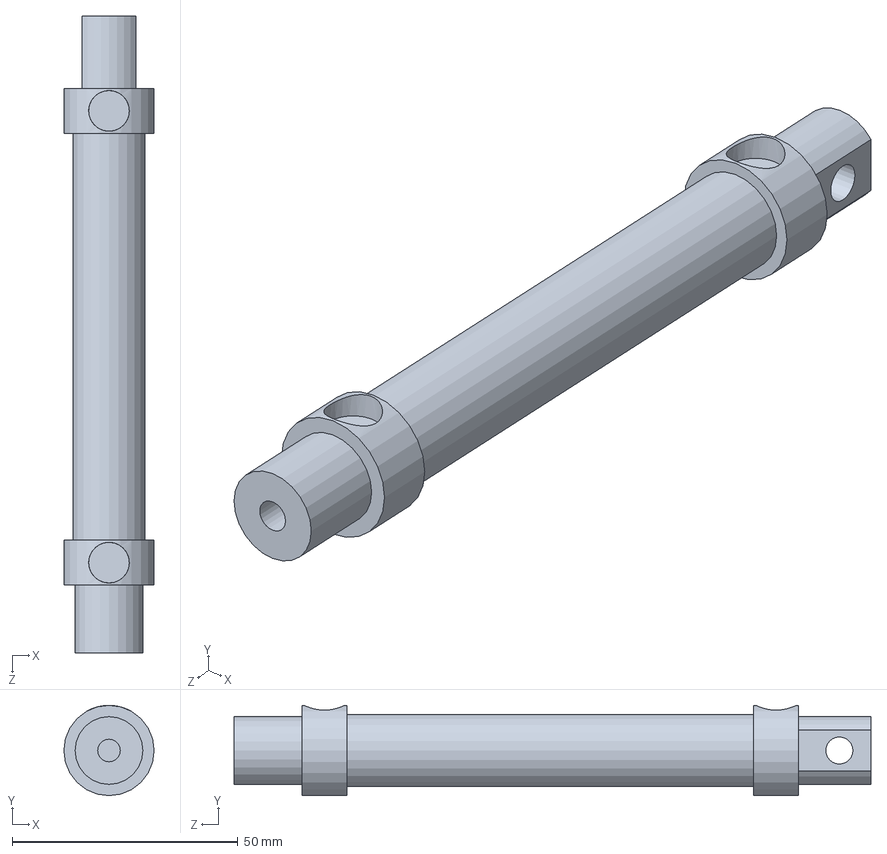
[picture p76: CAD file, 2022-07-13]
auto/thư viện/xilanh HT50 pi 16.SLDPRT
20.0 x 20.0 x 141.0 mm
