teno1608/Do-An-Tot-Nghiep-2014/auto/encoder/hop10x10x100.SLDPRT

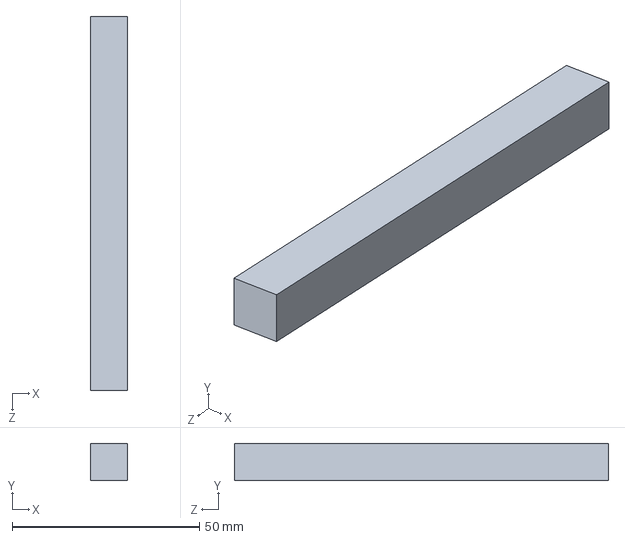
[picture p77: CAD file, 2022-07-13]
auto/encoder/hop10x10x100.SLDPRT
10.0 x 10.0 x 100.0 mm
