teno1608/Do-An-Tot-Nghiep-2014/auto/de auto.SLDPRT

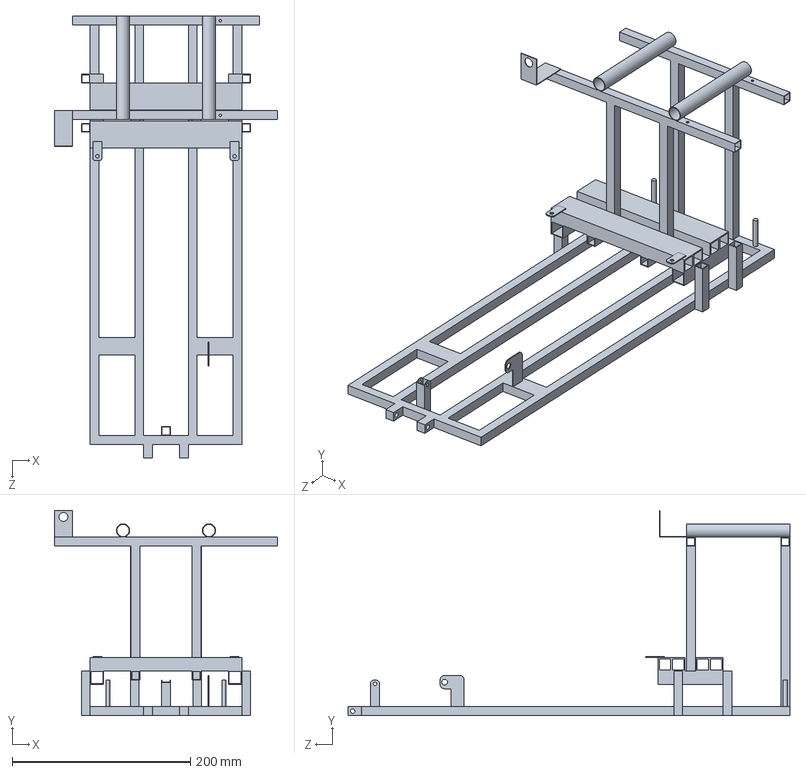
[picture p78: CAD file, 2022-07-13]
auto/de auto.SLDPRT
250.0 x 230.0 x 495.0 mm
