teno1608/Do-An-Tot-Nghiep-2014/auto/encoder/lay.SLDPRT

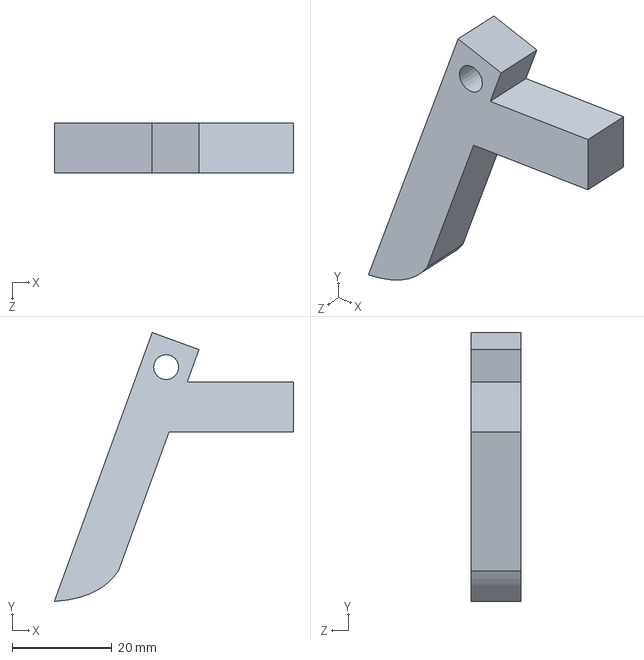
[picture p79: CAD file, 2022-07-13]
auto/encoder/lay.SLDPRT
48.0 x 53.9 x 10.0 mm
