teno1608/Do-An-Tot-Nghiep-2014/auto/thư viện/dong co leb.SLDPRT

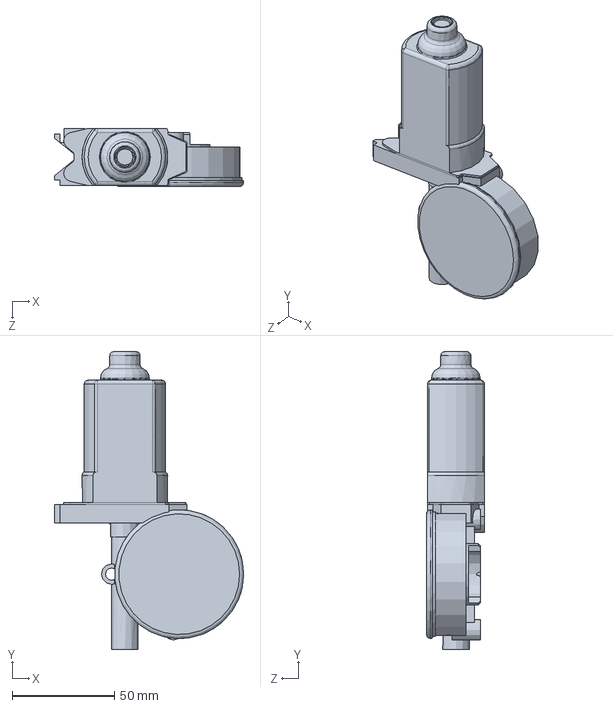
[picture p80: CAD file, 2022-07-13]
auto/thư viện/dong co leb.SLDPRT
92.8 x 146.0 x 28.5 mm
