teno1608/Do-An-Tot-Nghiep-2014/auto/encoder/oc pitong.SLDPRT

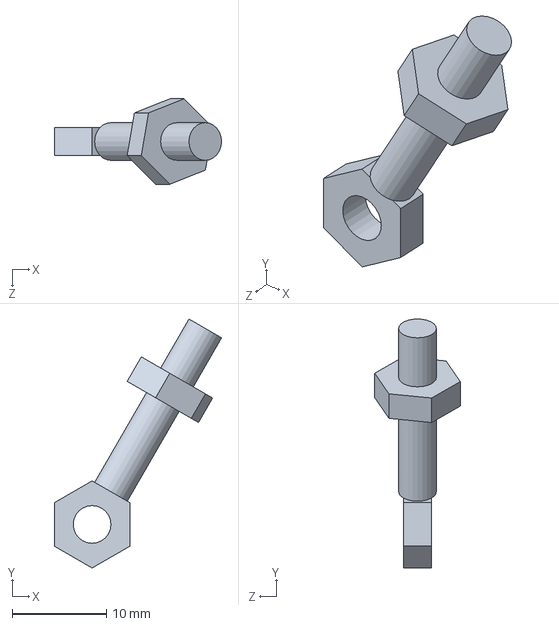
[picture p81: CAD file, 2022-07-13]
auto/encoder/oc pitong.SLDPRT
17.7 x 26.4 x 9.07 mm
