teno1608/Do-An-Tot-Nghiep-2014/auto/thư viện/xilanh 50 pi10.SLDPRT

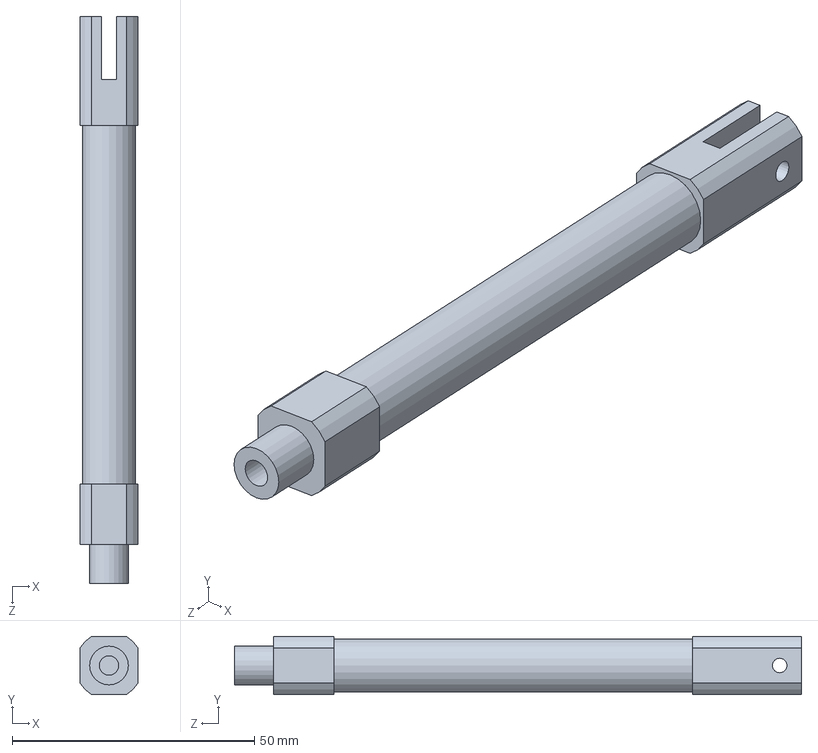
[picture p82: CAD file, 2022-07-13]
auto/thư viện/xilanh 50 pi10.SLDPRT
12.0 x 12.0 x 117.0 mm
