teno1608/Do-An-Tot-Nghiep-2014/auto/ma kep trai.SLDPRT

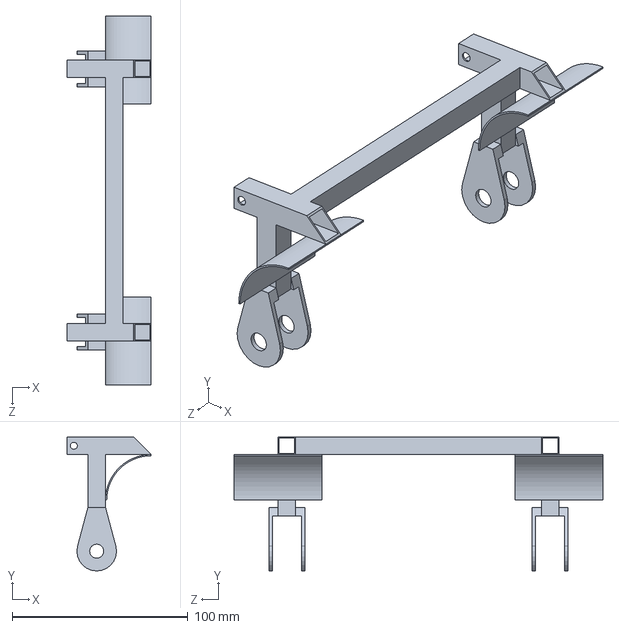
[picture p83: CAD file, 2022-07-13]
auto/ma kep trai.SLDPRT
48.0 x 76.3 x 210.0 mm
