teno1608/Do-An-Tot-Nghiep-2014/auto/thư viện/trục xilanh 100.SLDPRT

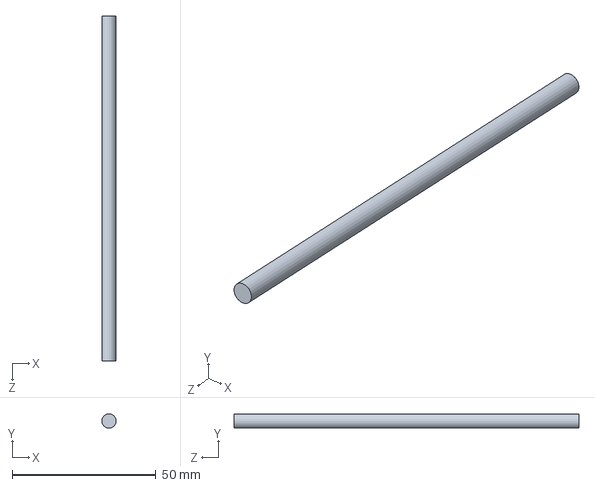
[picture p84: CAD file, 2022-07-13]
auto/thư viện/trục xilanh 100.SLDPRT
5.00 x 5.00 x 120.0 mm
