teno1608/Do-An-Tot-Nghiep-2014/auto/encoder/khung280x180.SLDPRT

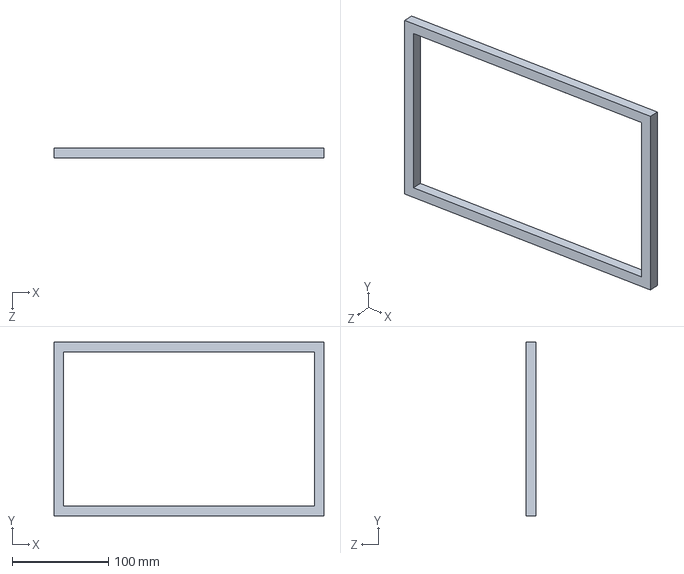
[picture p85: CAD file, 2022-07-13]
auto/encoder/khung280x180.SLDPRT
280.0 x 180.0 x 10.0 mm
