teno1608/Do-An-Tot-Nghiep-2014/auto/thư viện/xilanh 100.SLDPRT

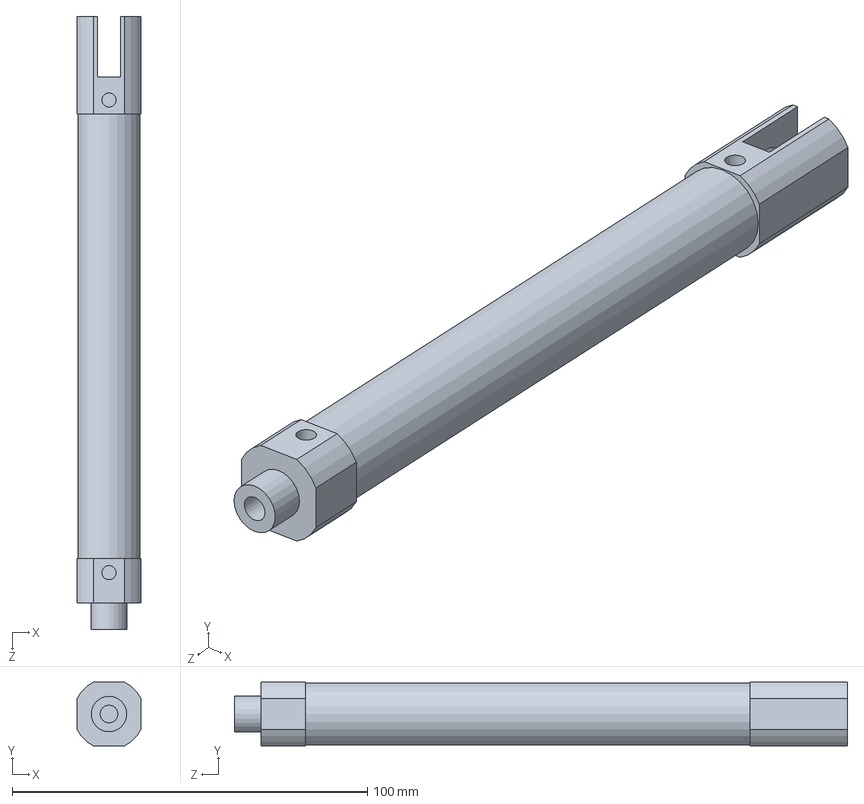
[picture p86: CAD file, 2022-07-13]
auto/thư viện/xilanh 100.SLDPRT
18.0 x 18.0 x 172.5 mm
