teno1608/Do-An-Tot-Nghiep-2014/auto/thư viện/Servo 100W-32V_1000xung - phien ban nhe.SLDPRT

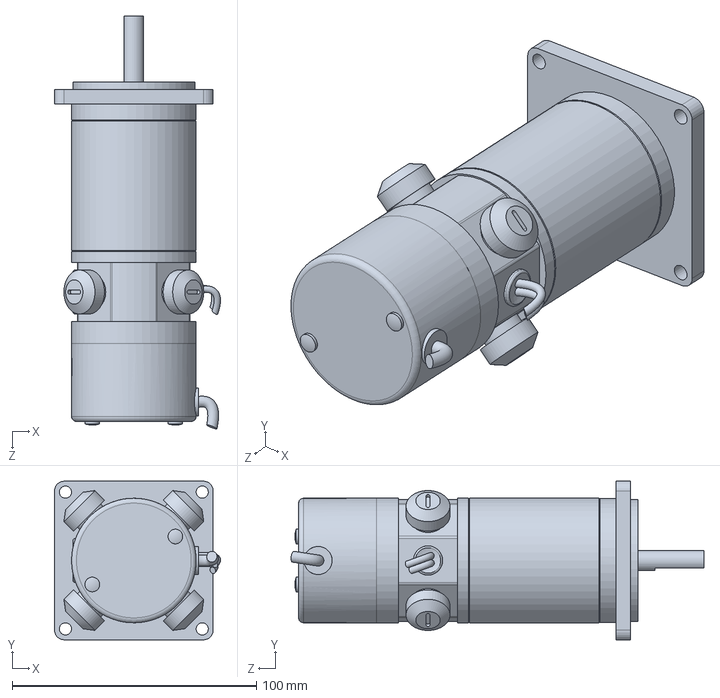
[picture p87: CAD file, 2022-07-13]
auto/thư viện/Servo 100W-32V_1000xung - phien ban nhe.SLDPRT
68.0 x 65.0 x 169.1 mm
