teno1608/Do-An-Tot-Nghiep-2014/auto/rayphai.SLDPRT

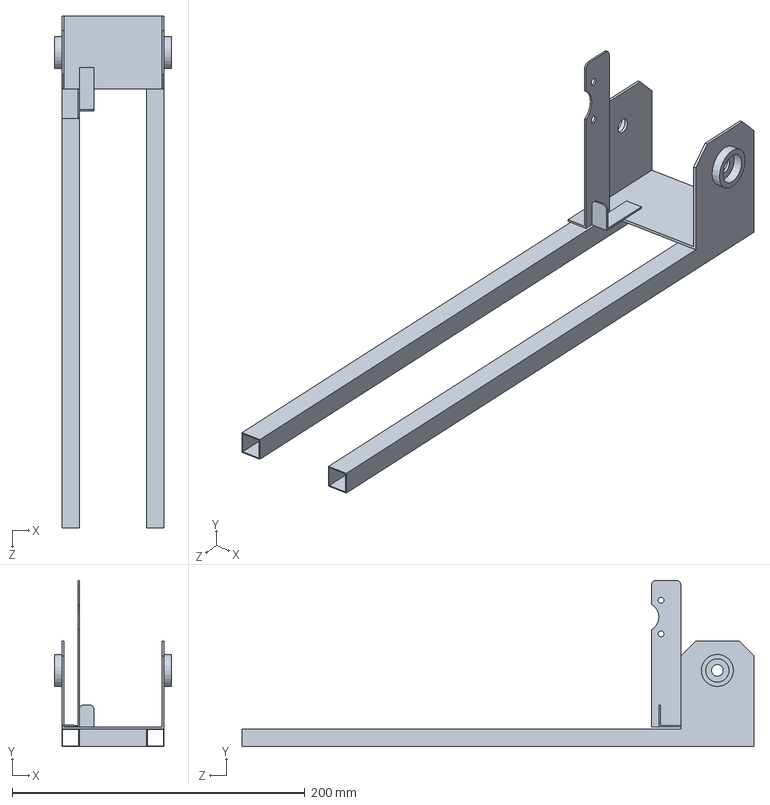
[picture p88: CAD file, 2022-07-13]
auto/rayphai.SLDPRT
80.0 x 113.5 x 350.0 mm
