teno1608/Do-An-Tot-Nghiep-2014/auto/thư viện/pitong_10_pi25 chinh xac.SLDPRT

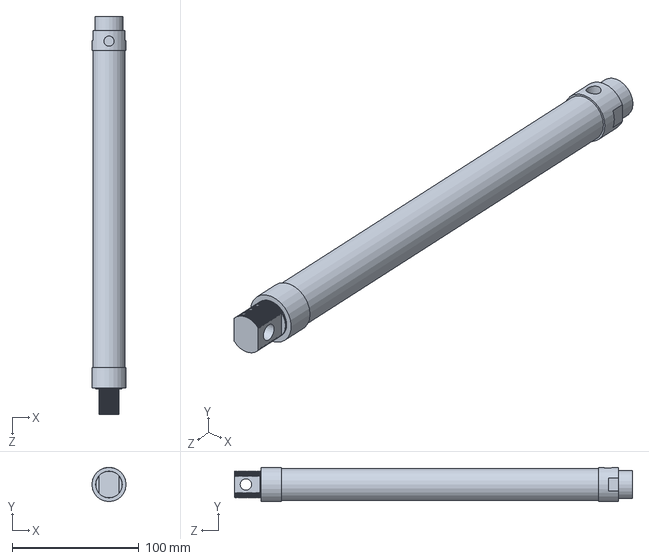
[picture p89: CAD file, 2022-07-13]
auto/thư viện/pitong_10_pi25 chinh xac.SLDPRT
27.0 x 27.0 x 314.0 mm
