teno1608/Do-An-Tot-Nghiep-2014/auto/thư viện/dong co vang.SLDPRT

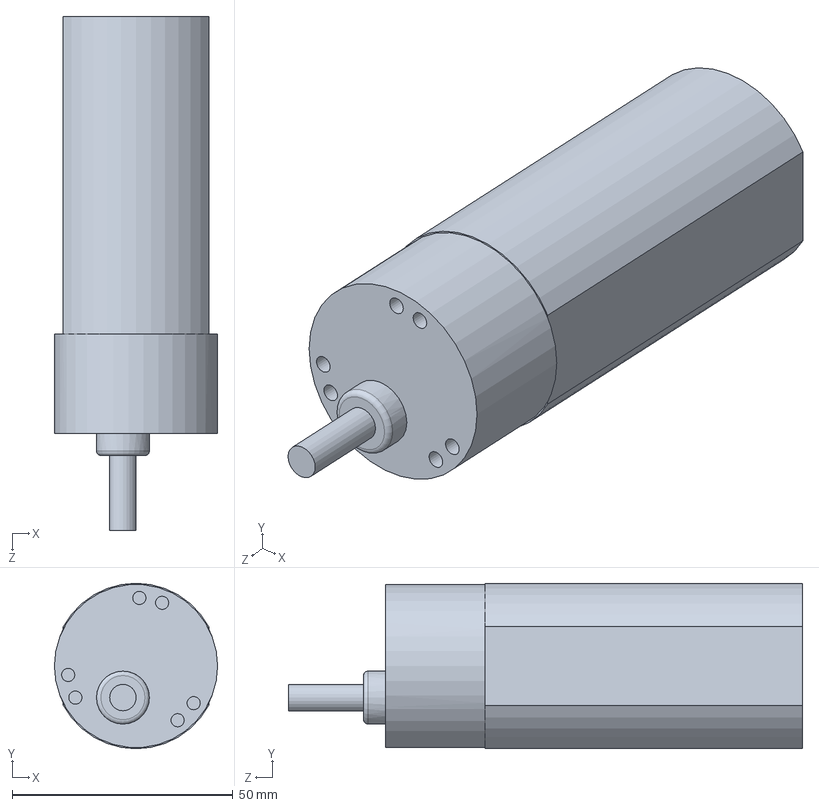
[picture p90: CAD file, 2022-07-13]
auto/thư viện/dong co vang.SLDPRT
37.0 x 37.5 x 116.5 mm
