teno1608/Do-An-Tot-Nghiep-2014/auto/thư viện/xilanh 50.SLDPRT

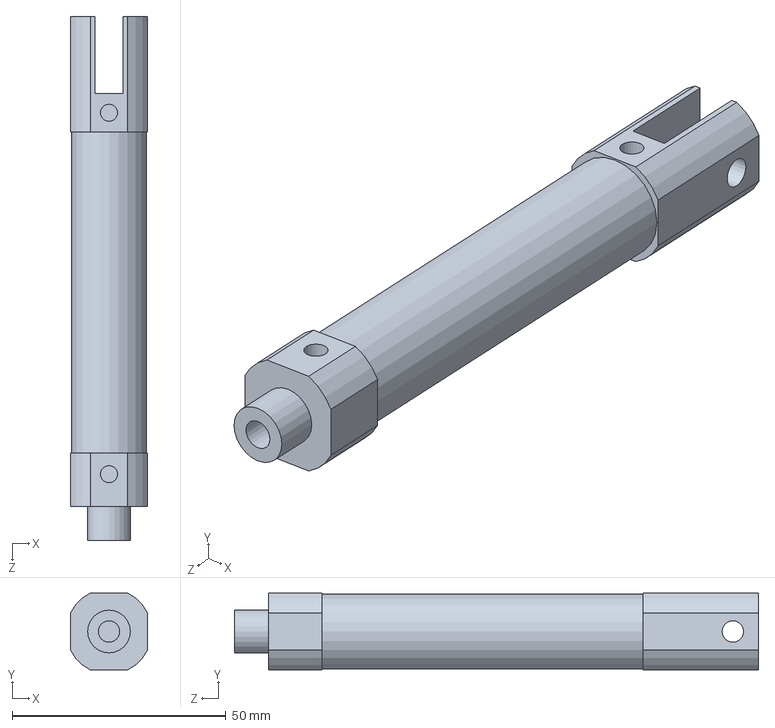
[picture p91: CAD file, 2022-07-13]
auto/thư viện/xilanh 50.SLDPRT
18.0 x 18.0 x 122.5 mm
