teno1608/Do-An-Tot-Nghiep-2014/auto/mac xich nho.SLDPRT

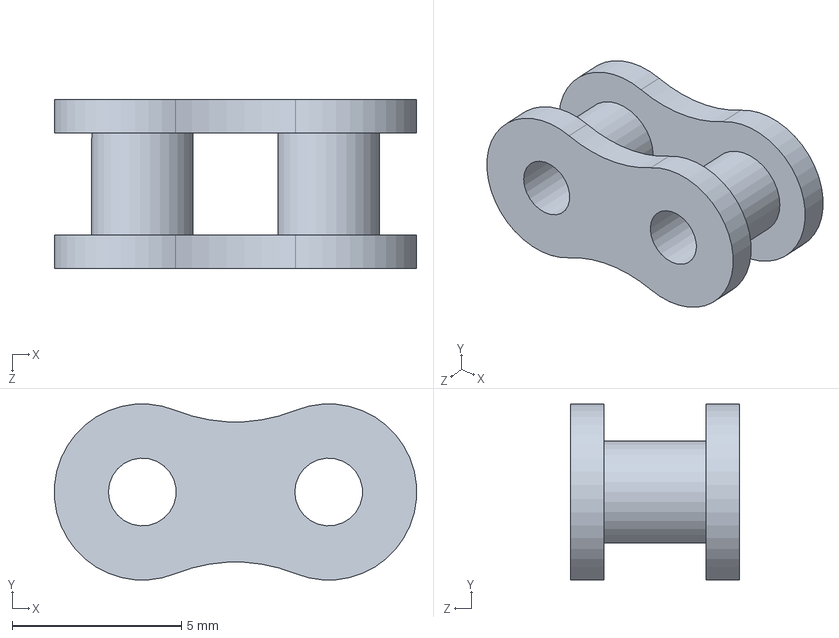
[picture p92: CAD file, 2022-07-13]
auto/mac xich nho.SLDPRT
10.7 x 5.19 x 5.00 mm
