teno1608/Do-An-Tot-Nghiep-2014/auto/thư viện/chu u.SLDPRT

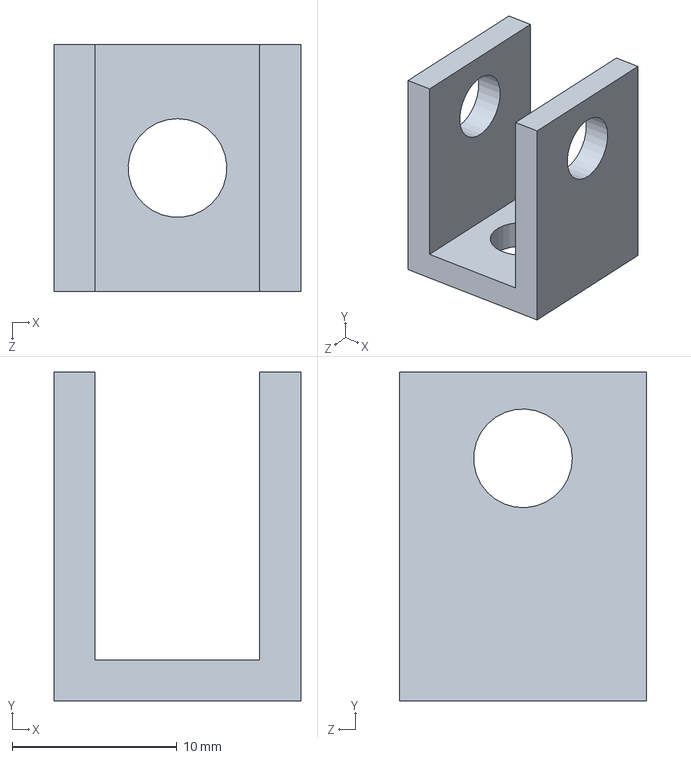
[picture p93: CAD file, 2022-07-13]
auto/thư viện/chu u.SLDPRT
15.0 x 20.0 x 15.0 mm
