teno1608/Do-An-Tot-Nghiep-2014/auto/banh rrang encoder.SLDPRT

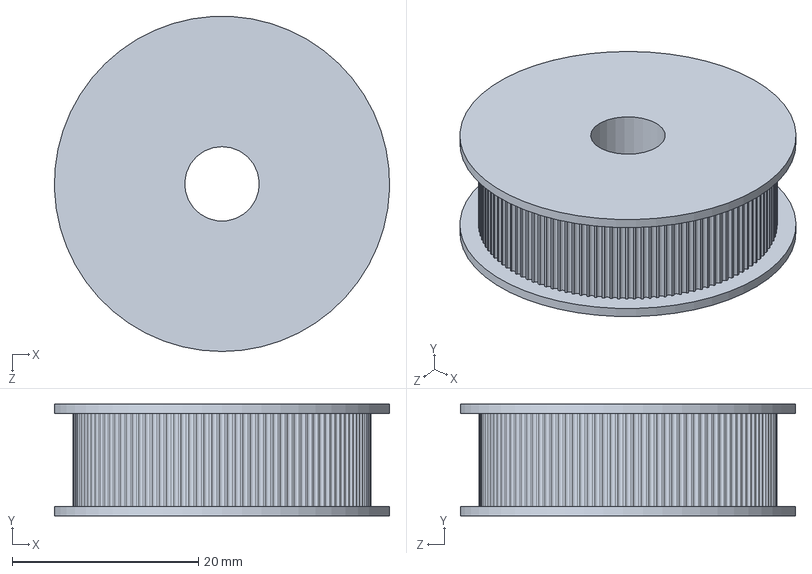
[picture p94: CAD file, 2022-07-13]
auto/banh rrang encoder.SLDPRT
36.0 x 12.0 x 36.0 mm
