teno1608/Do-An-Tot-Nghiep-2014/auto/ray_truot_ben.SLDPRT

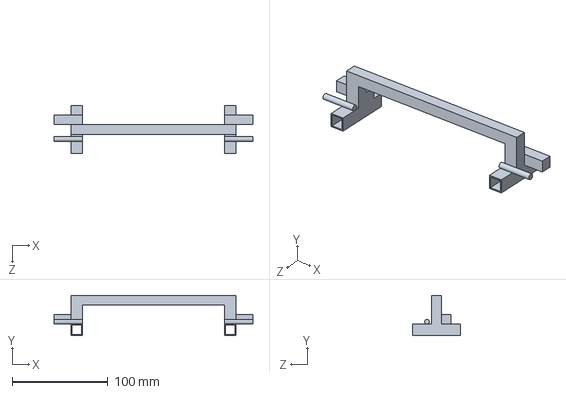
[picture p95: CAD file, 2022-07-13]
auto/ray_truot_ben.SLDPRT
208.0 x 42.0 x 50.0 mm
