teno1608/Do-An-Tot-Nghiep-2014/auto/oc pitong duoi.SLDPRT

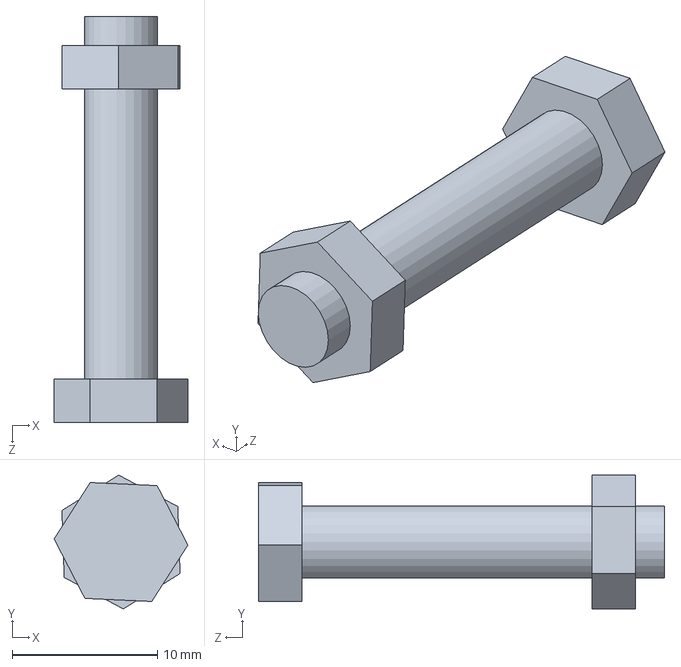
[picture p96: CAD file, 2022-07-13]
auto/oc pitong duoi.SLDPRT
9.23 x 9.23 x 28.0 mm
