teno1608/Do-An-Tot-Nghiep-2014/auto/thư viện/pitong_400_pi25 chinh xac.SLDPRT

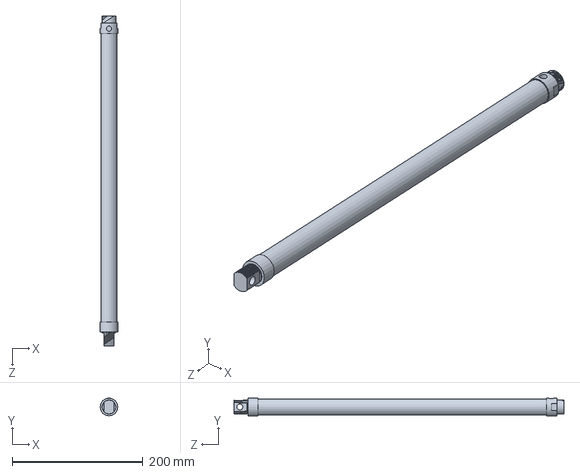
[picture p97: CAD file, 2022-07-13]
auto/thư viện/pitong_400_pi25 chinh xac.SLDPRT
27.0 x 27.0 x 504.0 mm
