teno1608/Do-An-Tot-Nghiep-2014/auto/thư viện/5.SLDPRT

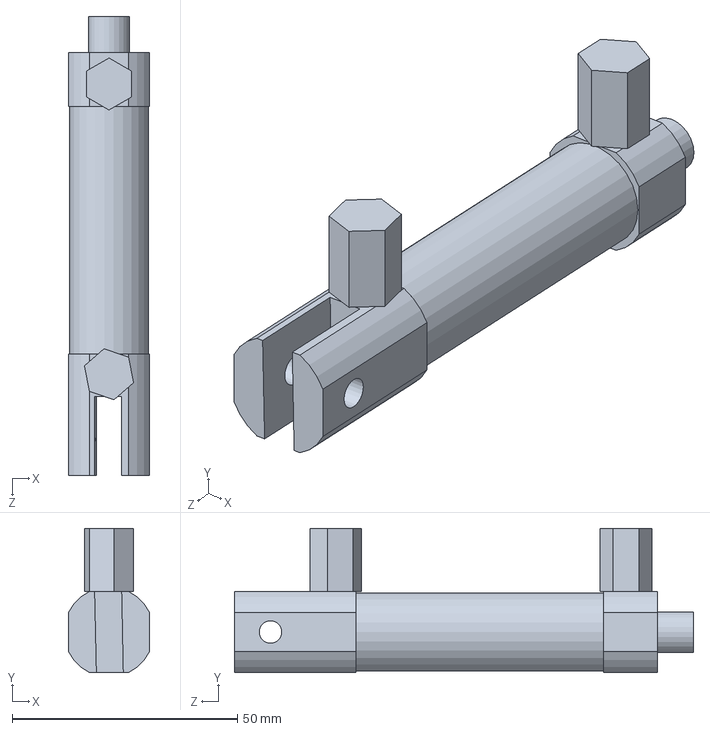
[picture p98: CAD file, 2022-07-13]
auto/thư viện/5.SLDPRT
18.0 x 32.0 x 102.0 mm
