teno1608/Do-An-Tot-Nghiep-2014/auto/o do bi leo thang.SLDPRT

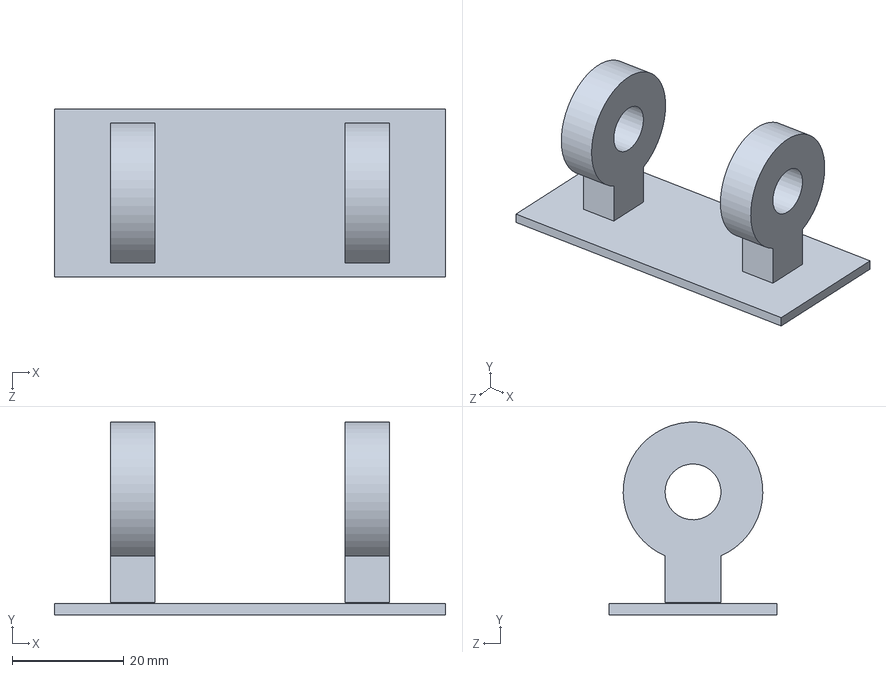
[picture p99: CAD file, 2022-07-13]
auto/o do bi leo thang.SLDPRT
70.0 x 34.5 x 30.0 mm
