teno1608/Do-An-Tot-Nghiep-2014/auto/thư viện/pitong_25_pi25 chinh xac.SLDPRT

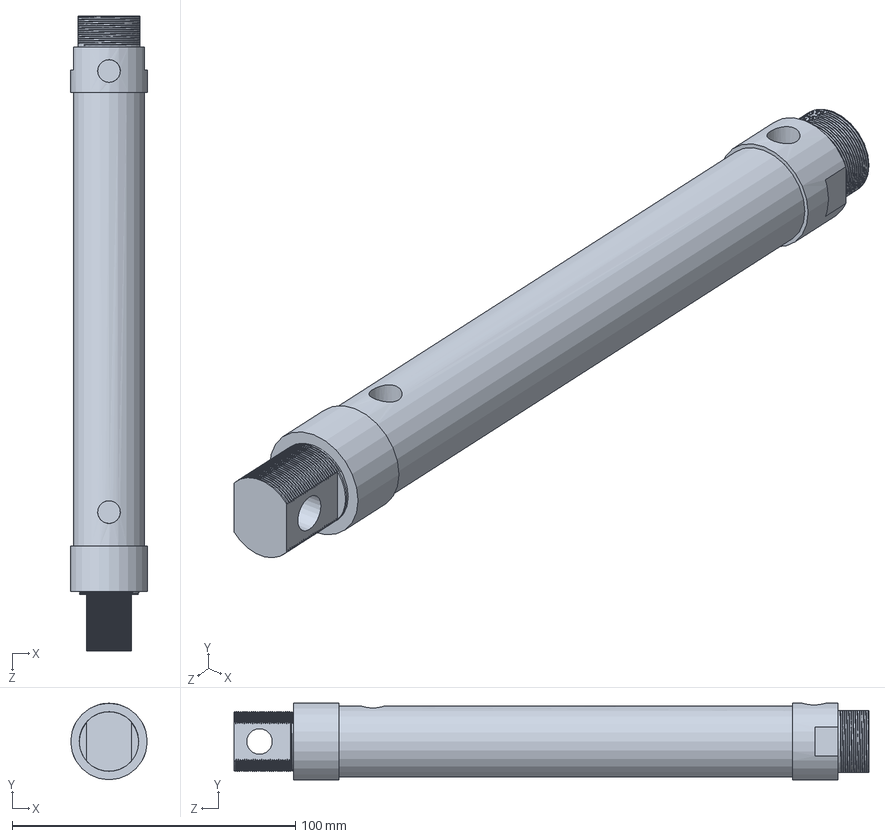
[picture p100: CAD file, 2022-07-13]
auto/thư viện/pitong_25_pi25 chinh xac.SLDPRT
27.0 x 27.0 x 224.0 mm
