teno1608/Do-An-Tot-Nghiep-2014/auto/thư viện/buli_dongco.SLDPRT

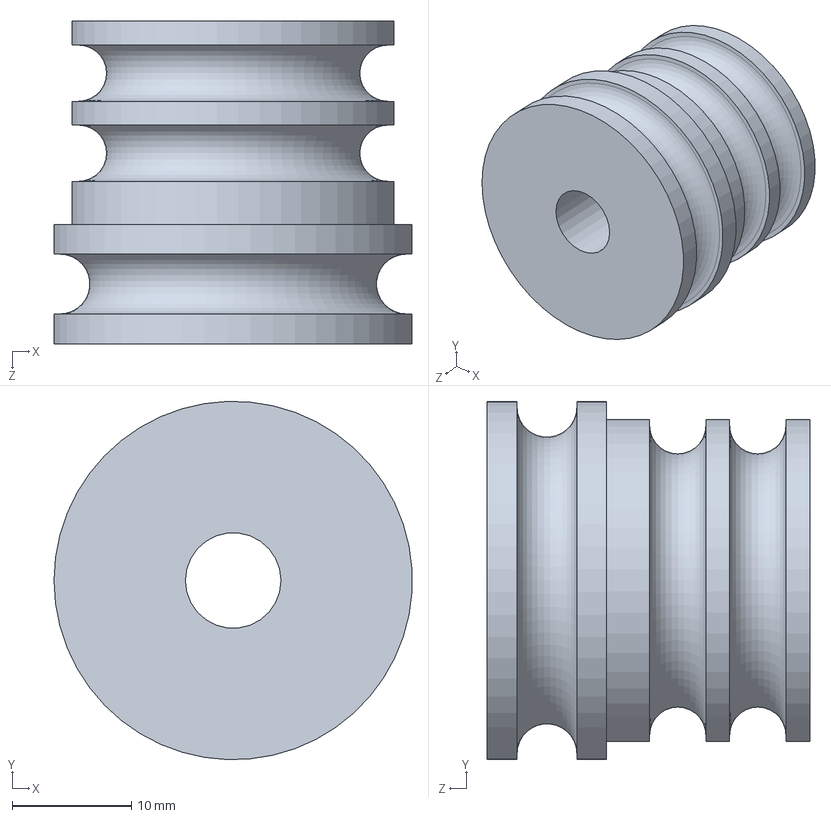
[picture p101: CAD file, 2022-07-13]
auto/thư viện/buli_dongco.SLDPRT
30.0 x 30.0 x 27.0 mm
