teno1608/Do-An-Tot-Nghiep-2014/auto/nhoong.SLDPRT

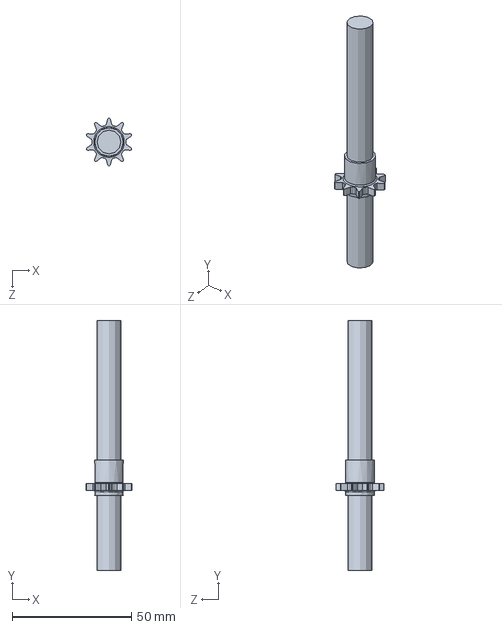
[picture p102: CAD file, 2022-07-13]
auto/nhoong.SLDPRT
19.1 x 105.0 x 20.0 mm
