teno1608/Do-An-Tot-Nghiep-2014/auto/thư viện/daunoipitong.SLDPRT

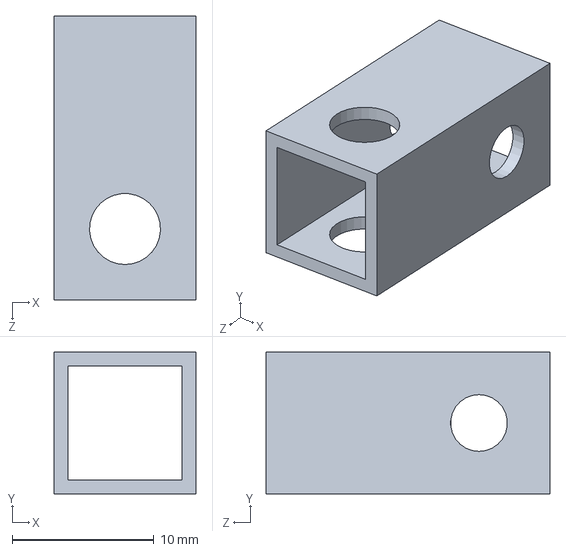
[picture p103: CAD file, 2022-07-13]
auto/thư viện/daunoipitong.SLDPRT
10.0 x 10.0 x 20.0 mm
