teno1608/Do-An-Tot-Nghiep-2014/auto/raytrai.SLDPRT

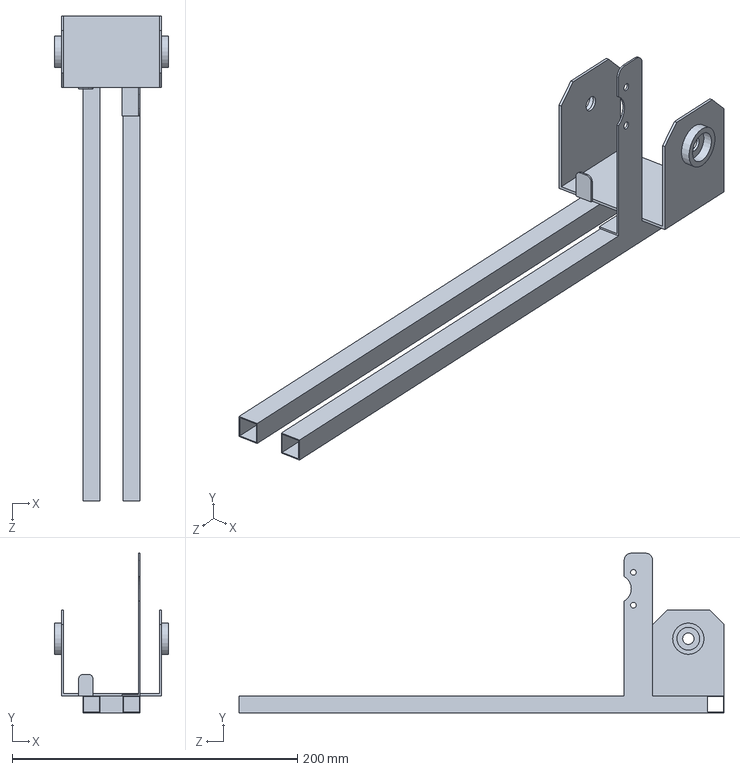
[picture p104: CAD file, 2022-07-13]
auto/raytrai.SLDPRT
80.0 x 112.0 x 340.0 mm
