teno1608/Do-An-Tot-Nghiep-2014/auto/thư viện/servo 75W.SLDPRT

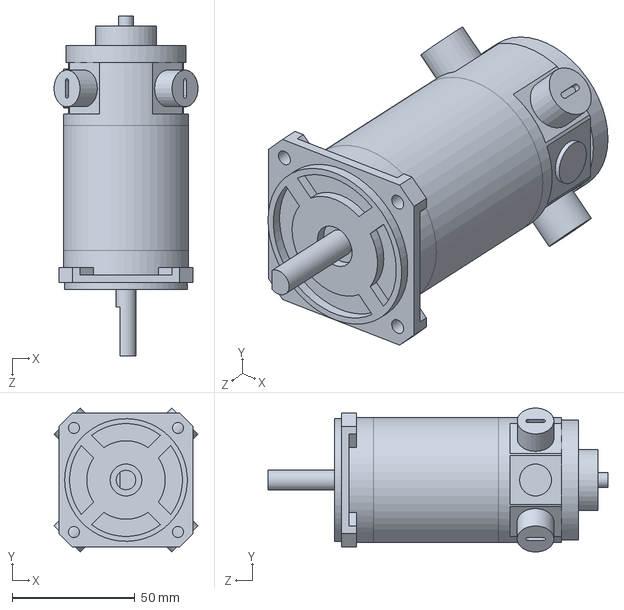
[picture p105: CAD file, 2022-07-13]
auto/thư viện/servo 75W.SLDPRT
58.7 x 58.7 x 138.5 mm
