teno1608/Do-An-Tot-Nghiep-2014/auto/buli vong day.SLDPRT

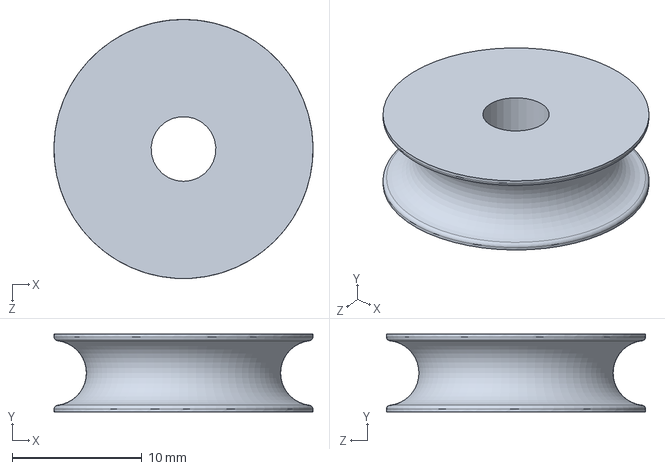
[picture p106: CAD file, 2022-07-13]
auto/buli vong day.SLDPRT
20.0 x 6.00 x 20.0 mm
