teno1608/Do-An-Tot-Nghiep-2014/auto/thư viện/dong co leb-d xuong.SLDPRT

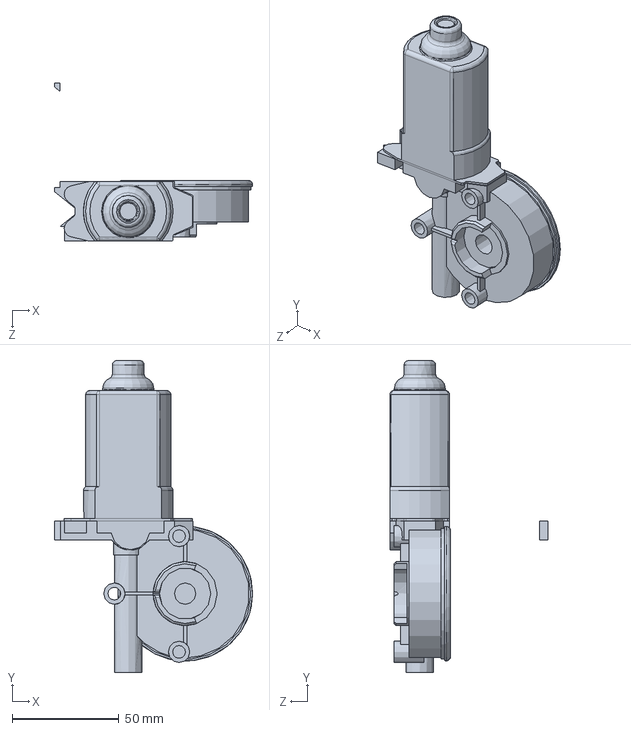
[picture p107: CAD file, 2022-07-13]
auto/thư viện/dong co leb-d xuong.SLDPRT
92.8 x 146.0 x 74.2 mm
