teno1608/Do-An-Tot-Nghiep-2014/auto/thư viện/pitong_10_pi25.SLDPRT

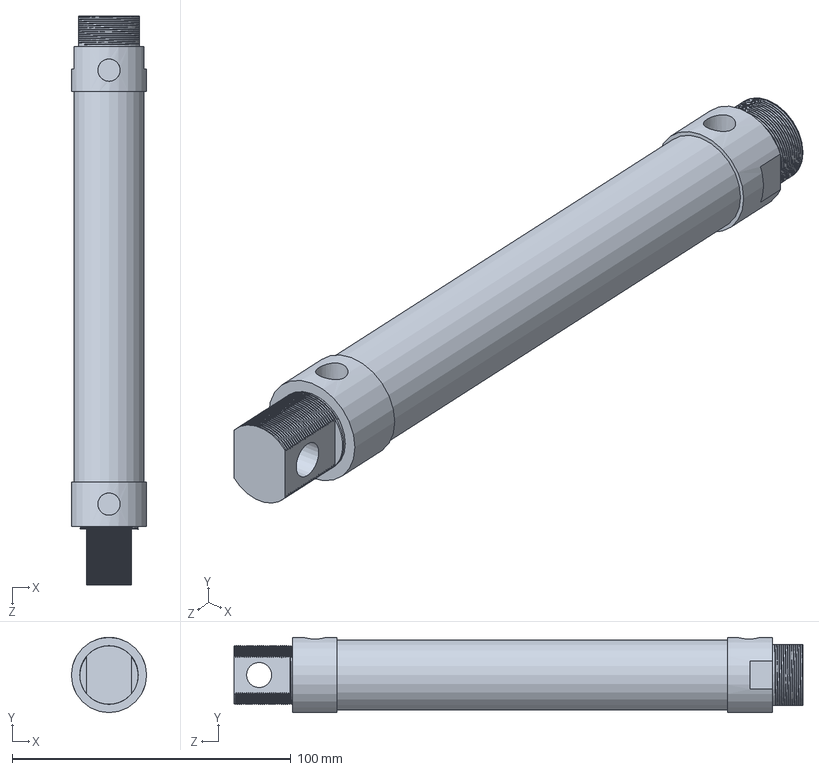
[picture p108: CAD file, 2022-07-13]
auto/thư viện/pitong_10_pi25.SLDPRT
27.0 x 27.0 x 204.0 mm
