teno1608/Do-An-Tot-Nghiep-2014/auto/thư viện/7.SLDPRT

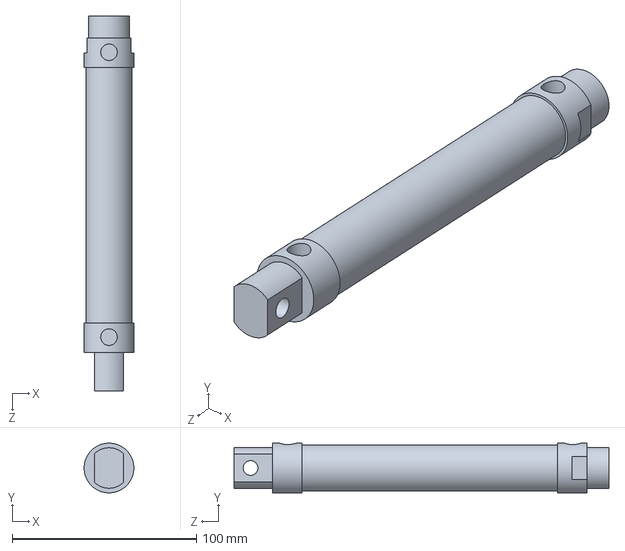
[picture p109: CAD file, 2022-07-13]
auto/thư viện/7.SLDPRT
27.0 x 27.0 x 203.5 mm
