teno1608/Do-An-Tot-Nghiep-2014/auto/thư viện/buli_trunggian.SLDPRT

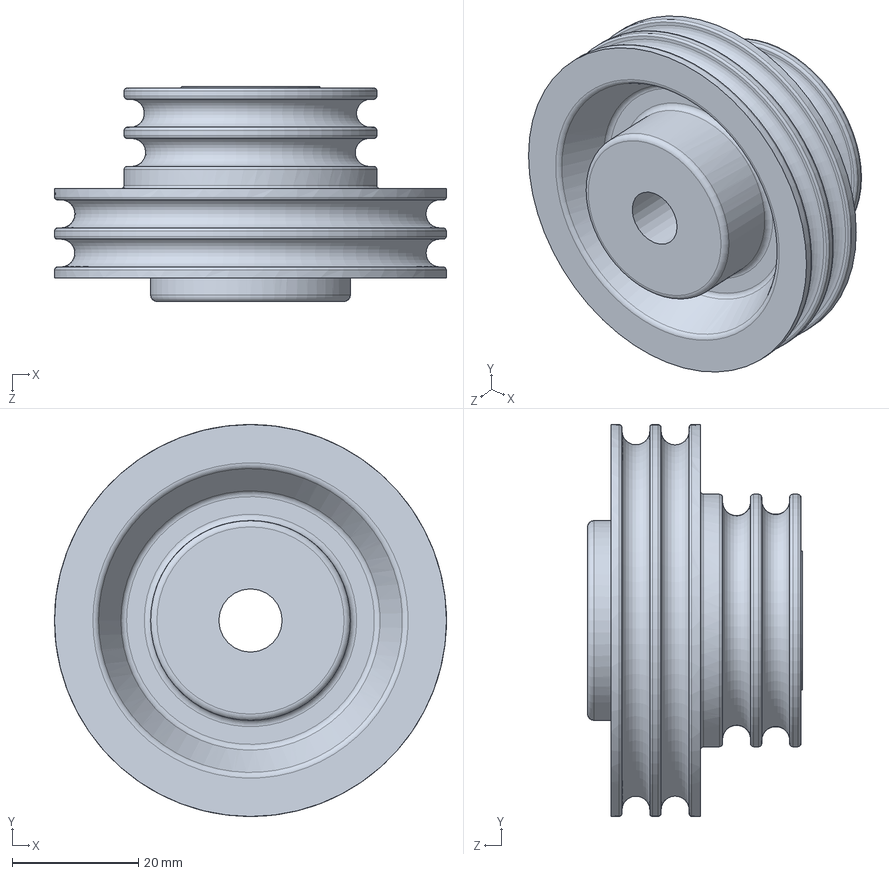
[picture p110: CAD file, 2022-07-13]
auto/thư viện/buli_trunggian.SLDPRT
62.0 x 62.0 x 34.0 mm
