teno1608/Do-An-Tot-Nghiep-2014/auto/thư viện/dc servo jamagawa 4.SLDPRT

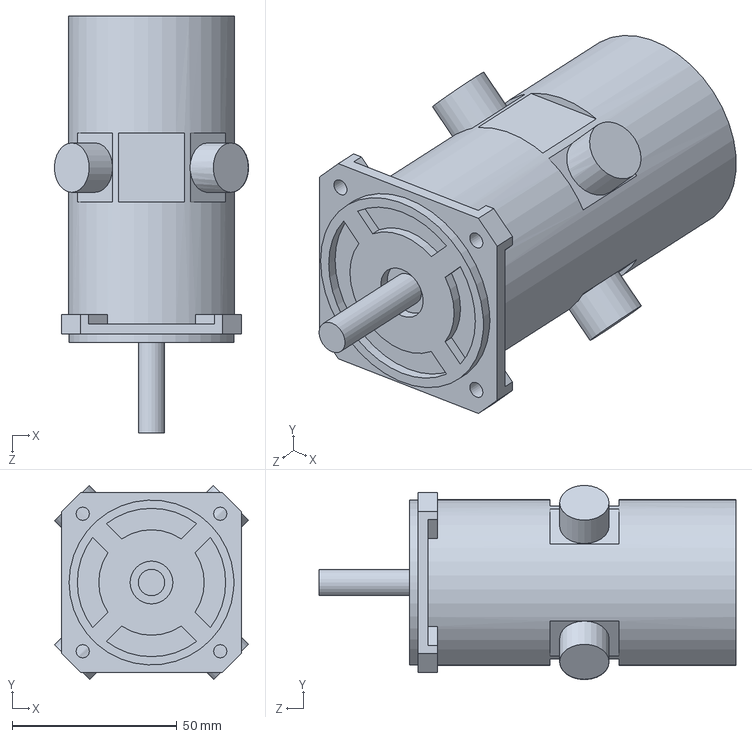
[picture p111: CAD file, 2022-07-13]
auto/thư viện/dc servo jamagawa 4.SLDPRT
58.9 x 58.9 x 126.5 mm
