teno1608/Do-An-Tot-Nghiep-2014/auto/thư viện/palanet.SLDPRT

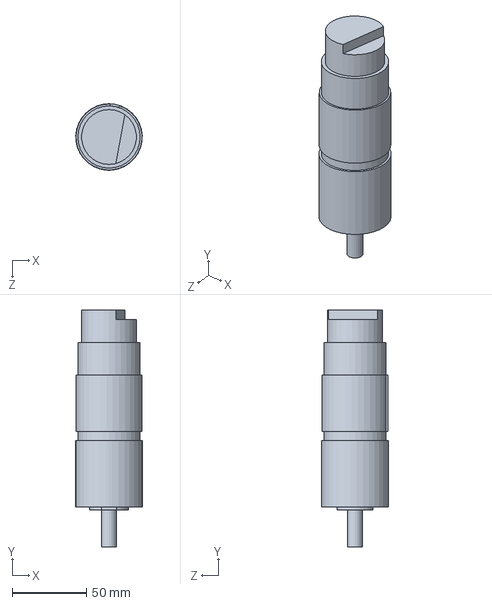
[picture p112: CAD file, 2022-07-13]
auto/thư viện/palanet.SLDPRT
44.9 x 160.0 x 45.0 mm
