teno1608/Do-An-Tot-Nghiep-2014/auto/thư viện/truc xi lanh goc 71.SLDPRT

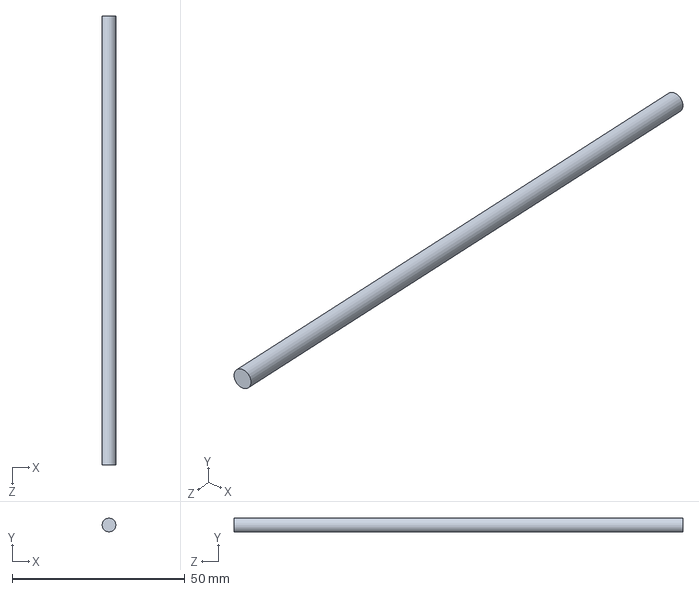
[picture p113: CAD file, 2022-07-13]
auto/thư viện/truc xi lanh goc 71.SLDPRT
4.00 x 4.00 x 130.0 mm
