teno1608/Do-An-Tot-Nghiep-2014/auto/thư viện/gidobulyyrunggian.SLDPRT

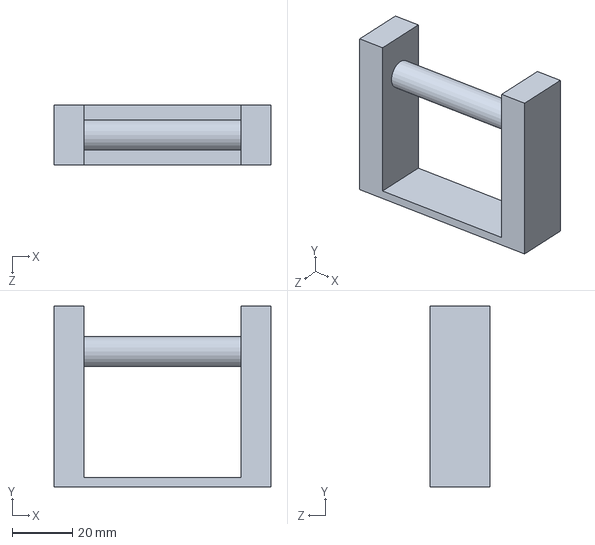
[picture p114: CAD file, 2022-07-13]
auto/thư viện/gidobulyyrunggian.SLDPRT
72.1 x 60.0 x 20.0 mm
