teno1608/Do-An-Tot-Nghiep-2014/auto/thư viện/nhoong.SLDPRT

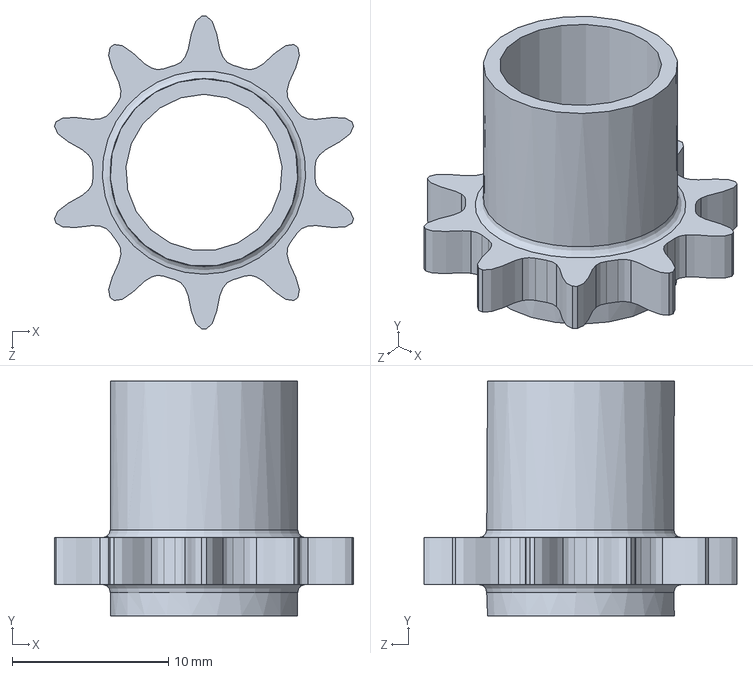
[picture p115: CAD file, 2022-07-13]
auto/thư viện/nhoong.SLDPRT
19.1 x 15.0 x 20.0 mm
