teno1608/Do-An-Tot-Nghiep-2014/auto/thư viện/xilanh5.SLDPRT

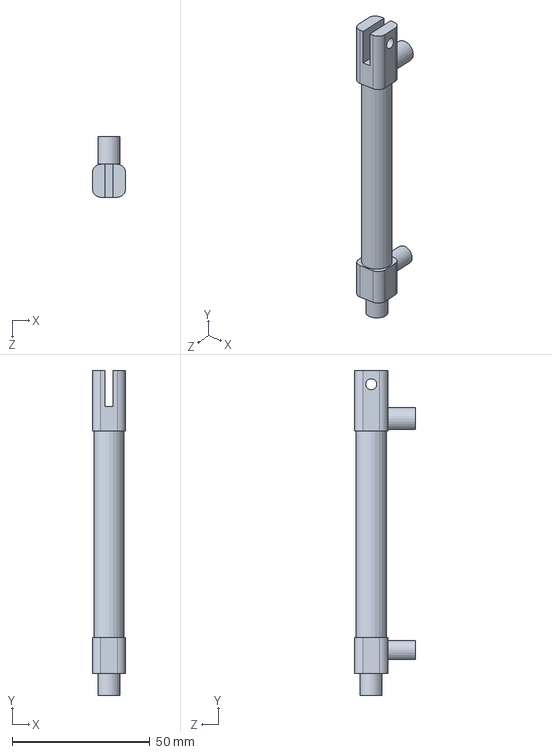
[picture p116: CAD file, 2022-07-13]
auto/thư viện/xilanh5.SLDPRT
12.0 x 118.0 x 22.0 mm
