teno1608/Do-An-Tot-Nghiep-2014/auto/thư viện/trục xilanh 50.SLDPRT

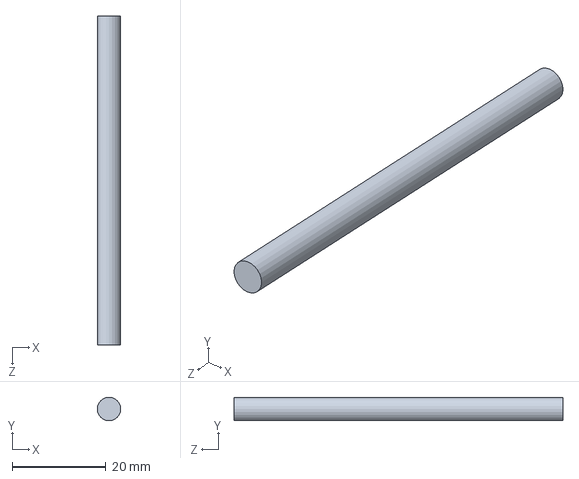
[picture p117: CAD file, 2022-07-13]
auto/thư viện/trục xilanh 50.SLDPRT
5.00 x 5.00 x 70.0 mm
