teno1608/Do-An-Tot-Nghiep-2014/auto/thư viện/lip(to).SLDPRT

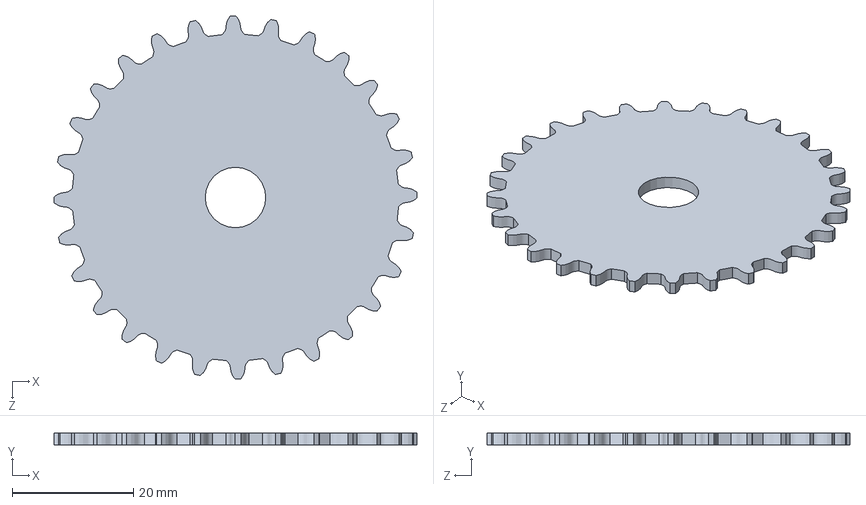
[picture p118: CAD file, 2022-07-13]
auto/thư viện/lip(to).SLDPRT
60.0 x 2.00 x 60.0 mm
