teno1608/Do-An-Tot-Nghiep-2014/auto/thư viện/Copy of buli_dongco.SLDPRT

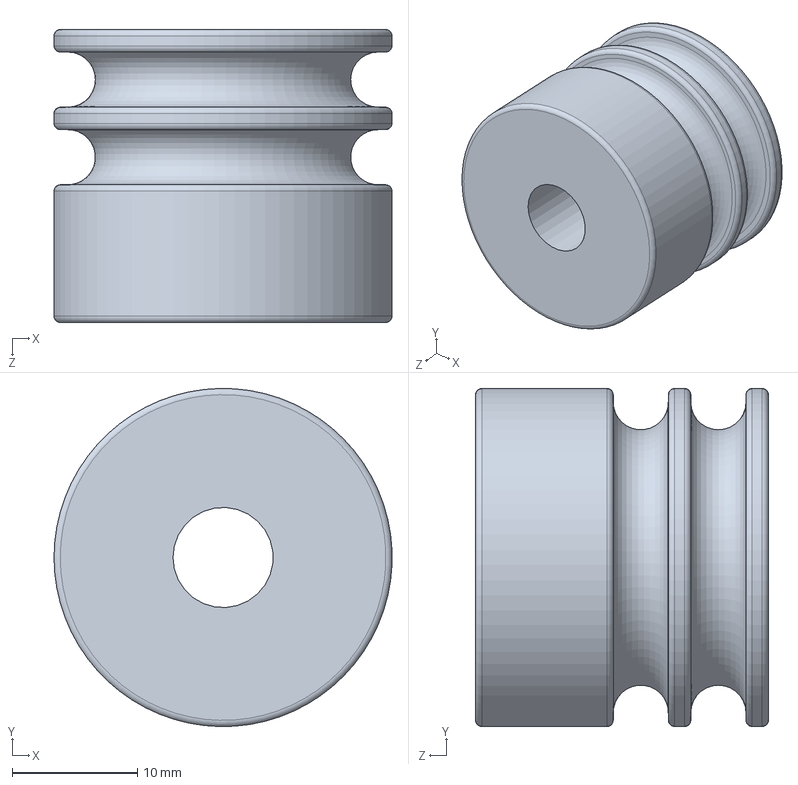
[picture p119: CAD file, 2022-07-13]
auto/thư viện/Copy of buli_dongco.SLDPRT
27.0 x 27.0 x 23.4 mm
