teno1608/Do-An-Tot-Nghiep-2014/auto/thư viện/trục xilanh 75.SLDPRT

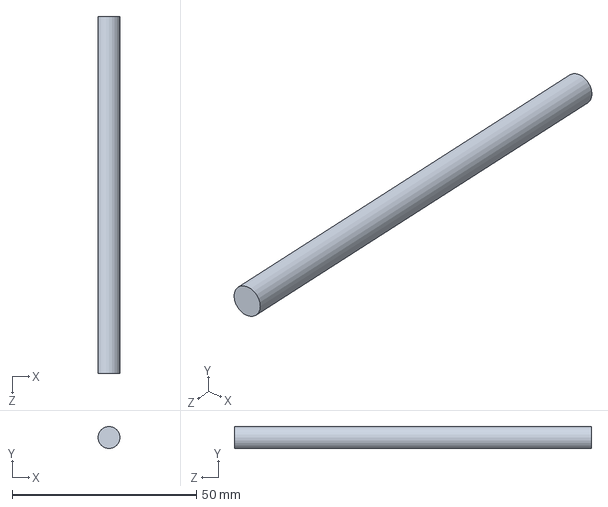
[picture p120: CAD file, 2022-07-13]
auto/thư viện/trục xilanh 75.SLDPRT
6.00 x 6.00 x 97.0 mm
