teno1608/Do-An-Tot-Nghiep-2014/auto/thư viện/banh tu lua.SLDPRT

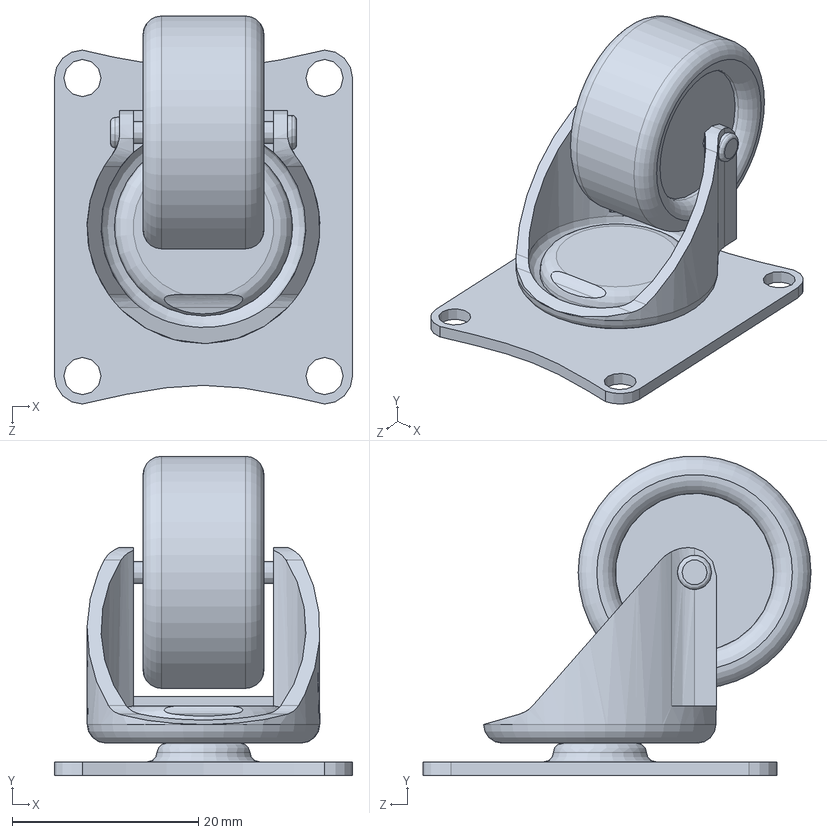
[picture p121: CAD file, 2022-07-13]
auto/thư viện/banh tu lua.SLDPRT
32.0 x 34.3 x 41.7 mm
