teno1608/Do-An-Tot-Nghiep-2014/(list of files, cad)

Other CAD files:
auto/thư viện/banh xe da huong.SLDASM
auto/encoder/Imported1.sldprt
ban ve co khi/lap rap ma kep.DWG
di in/ban ve mach luu do xong.dwg
di in/danh dia/ban ve mach luu do thuat toan.dwg
mach autocad/mach dong luc tu dong.dxf
mach autocad/New folder/mater pic tu dong moi.dxf
auto/encoder/Imported4.sldprt
ban ve co khi/thuanedit1.dwg
di in/danh dia/banve co khi.dwg
mach autocad/mach dong luc dc lep.DXF
auto/encoder/SEESAW.sldprt
auto/lay.DWG
ban ve co khi/than tay kep.DWG
mach autocad/mach pid pic.dxf
auto/dong co led trai tay.SLDPRT
auto/thư viện/xilanh 30.SLDPRT
ban ve co khi/tay kep.DWG
mach autocad/SO DO MACH + LU DO THUAT TOAN bang tay.dwg
auto/thư viện/onmi2/buli_tua100.SLDPRT
ban ve co khi/o do bi leo thang.DWG
mach autocad/SO DO MACH + LU DO THUAT TOAN tu dong.dwg
ban ve co khi/lancuoi.dwg
mach autocad/mater pic bang tay.dxf
ban ve co khi/ban ve final 22-5.dwg
mach autocad/mater pic tu dong.dxf
auto/encoder/Imported2.sldprt
ban ve co khi/lap rap canh tay trai.DWG
mach autocad/mach kich van.dxf
ban ve co khi/ban ve mach luu do xong.dwg
ban ve co khi/raytrai.DWG
auto/encoder/Imported3.sldprt
ban ve co khi/Drawing1.dwg
auto/dong co led tay.SLDPRT
ban ve co khi/lap rap hoan chinh auto robot.DWG
auto/lap rap hoan chinh auto robot22222222222222222222222.DWG
ban ve co khi/Drawing2.dwg
ban ve co khi/ma kep trai.DWG
ban ve co khi/khung canh tay phai.DWG
ban ve co khi/tinh luc leo cau thang.dwg
ban ve co khi/banvechitietsua.dwg
auto/thư viện/xilanh HT75 pi 16.SLDPRT
auto/lap rap hoan chinh auto robot2(auto cad).DWG
auto/thư viện/dong co leb Trái.SLDPRT
auto/ma kep phai.SLDPRT
auto/thư viện/pitong_15_pi25 chinh xac.SLDPRT
auto/thư viện/lip(to)1.DWG
auto/cơ cấu trượt lên thang ngoài.DWG
auto/cơ cấu trượt lên thang ngoài.SLDDRW
auto/de auto.DWG
auto/de auto.SLDDRW
auto/doan xich2.DWG
auto/doan xich2.SLDDRW
auto/duoi.DWG
auto/duoi.SLDDRW
auto/lap rap canh tay phai.DWG
auto/lap rap canh tay phai.SLDDRW
auto/lap rap canh tay trai.DWG
auto/lap rap canh tay trai.SLDDRW
auto/lap rap hoan chinh auto robot2.SLDDRW
auto/lap rap hoan chinh auto robot23.SLDDRW
auto/lay.SLDDRW
auto/lip(to).SLDDRW
auto/ma kep trai.DWG
auto/ma kep trai.SLDDRW
auto/thư viện/lip(to).DWG
auto/trượt lên thang trong.DWG
auto/trượt lên thang trong.SLDDRW
ban ve co khi/5555555.dwg
mach autocad/mach dong luc dc lep.dwg
mach autocad/mach dong luc tu dong.dwg
mach autocad/mach kich van.dwg
mach autocad/mach pid pic.dwg
mach autocad/mater pic bang tay.dwg
mach autocad/mater pic tu dong.dwg
